Hosty-04/ChickenCoop/Flowcharts/door_flowchart_white.png

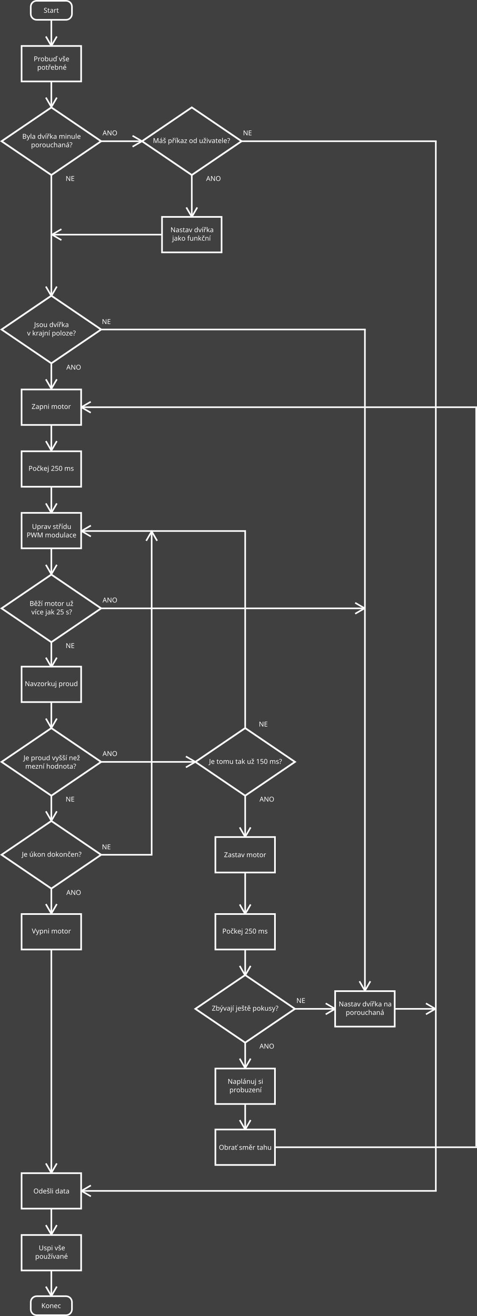
Flowcharts/door_flowchart_white.png
