Hosty-04/ChickenCoop/Flowcharts/egg_detection_flowchart_white.png

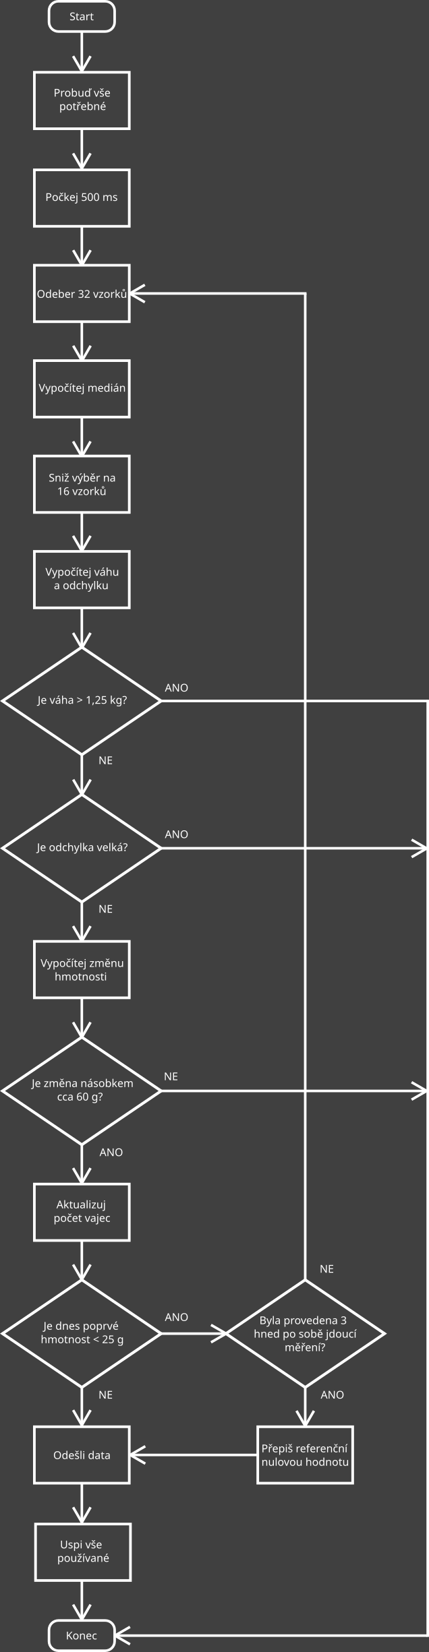
Flowcharts/egg_detection_flowchart_white.png
