Hosty-04/ChickenCoop/Flowcharts/separator_flowchart_white.png

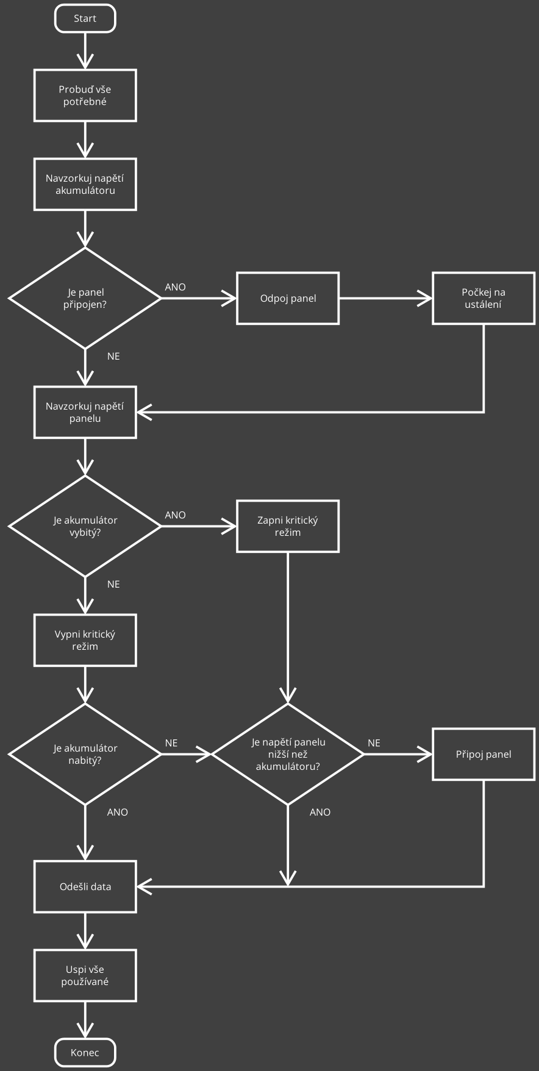
Flowcharts/separator_flowchart_white.png
