Hosty-04/ChickenCoop/Images/master_clock.png

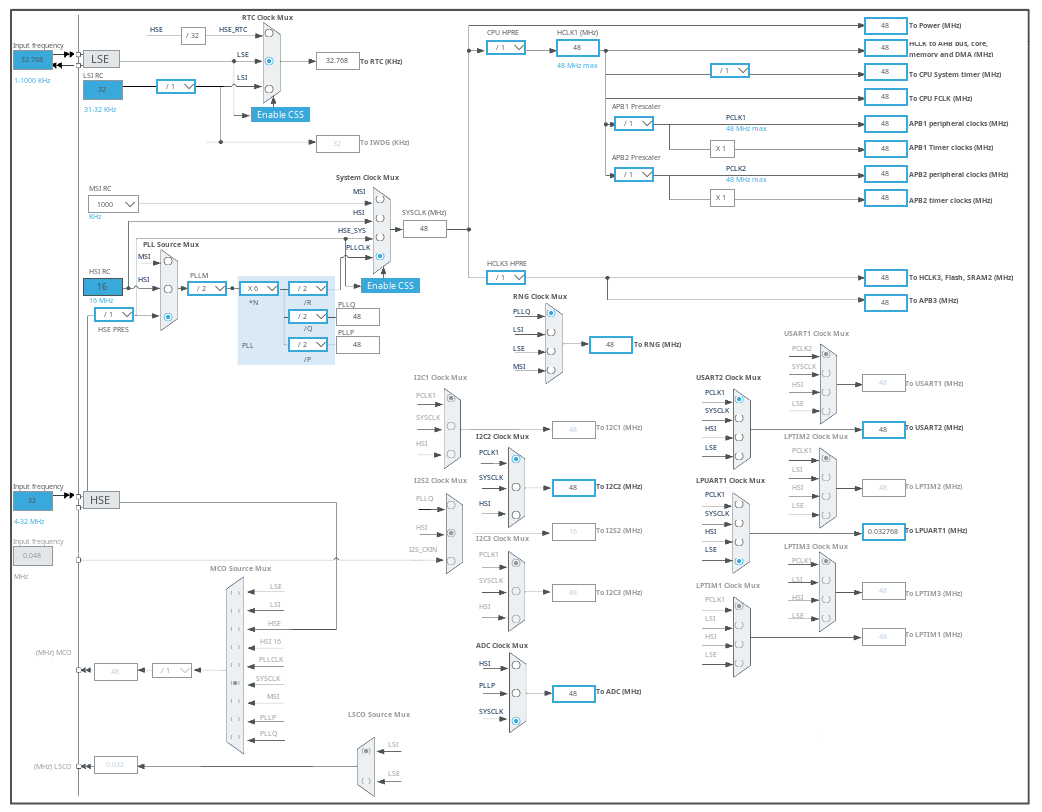
Images/master_clock.png
