Hosty-04/ChickenCoop/Images/master_gpio.png

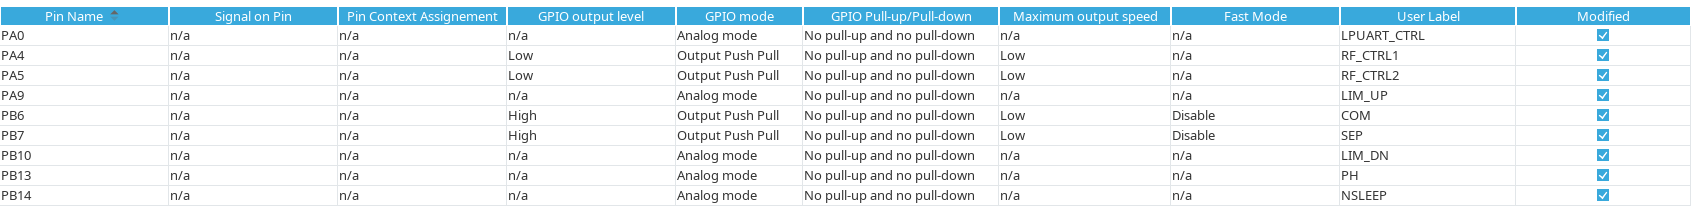
Images/master_gpio.png
