Hosty-04/ChickenCoop/Images/master_pinout.png

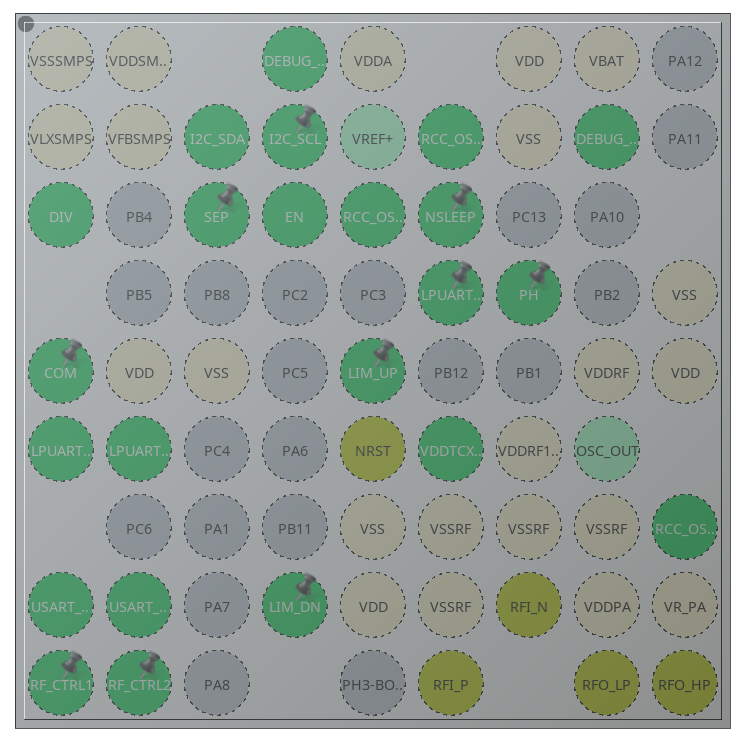
Images/master_pinout.png
