Hosty-04/ChickenCoop/Images/master_system.png

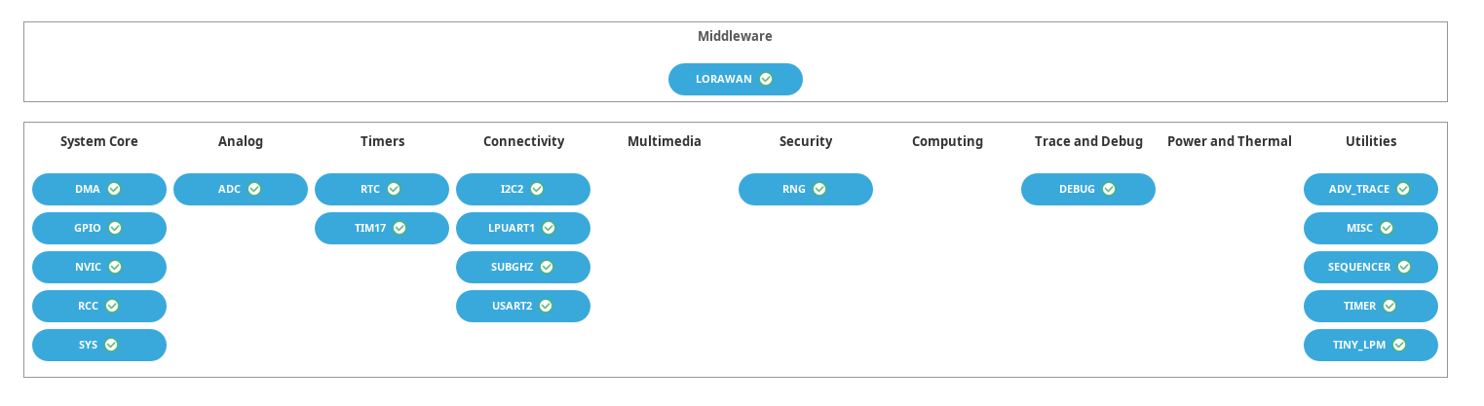
Images/master_system.png
