Hosty-04/ChickenCoop/Images/slave_clock.png

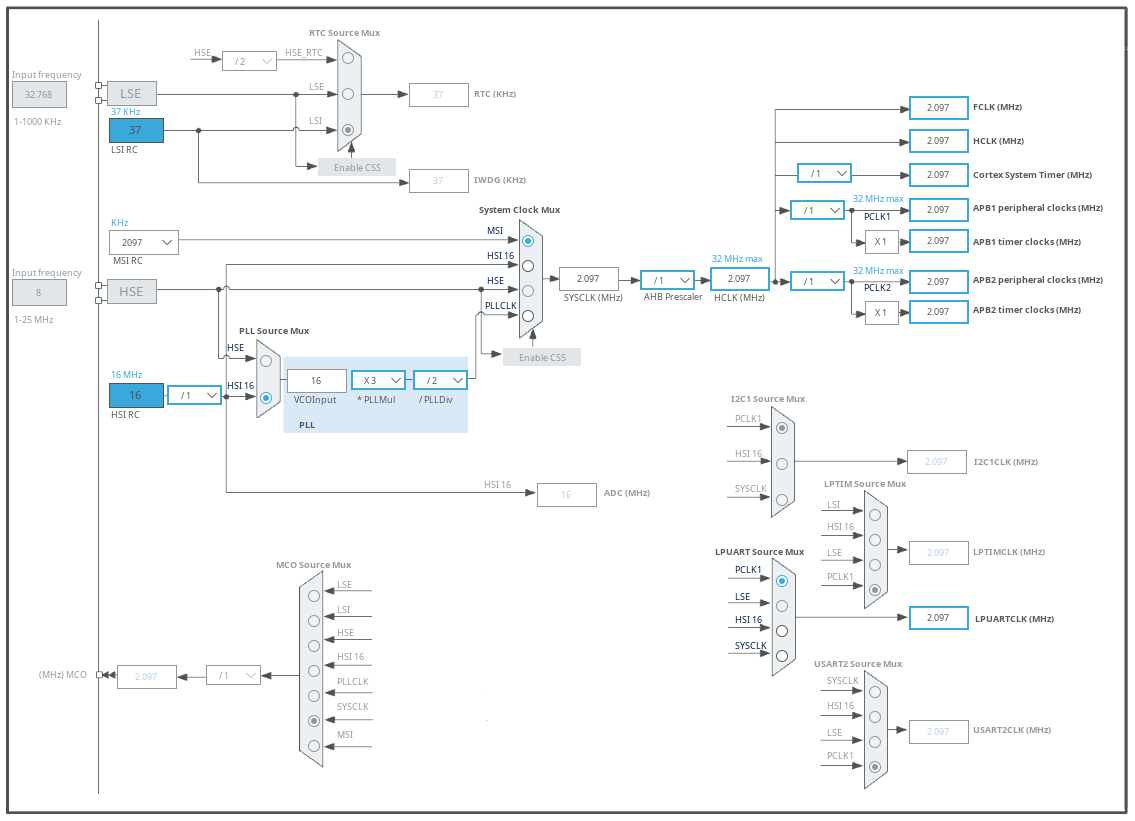
Images/slave_clock.png
