Hosty-04/ChickenCoop/Images/slave_pinout.png

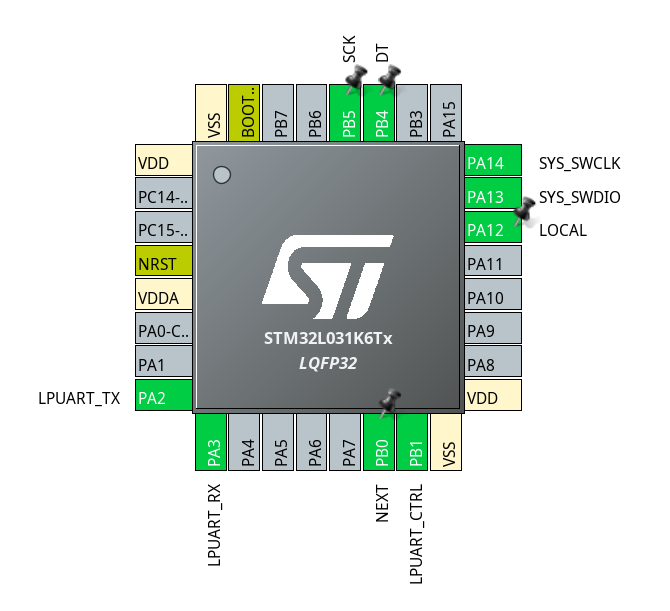
Images/slave_pinout.png
