Hosty-04/ChickenCoop/Schematics/block_schematic_comms_white.png

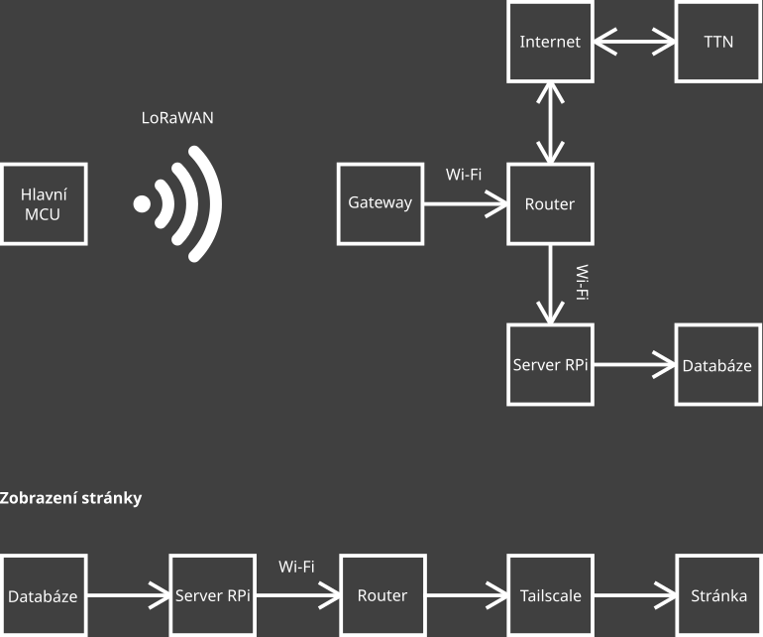
Schematics/block_schematic_comms_white.png
