Hosty-04/ChickenCoop/Schematics/block_schematic_electronics_white.png

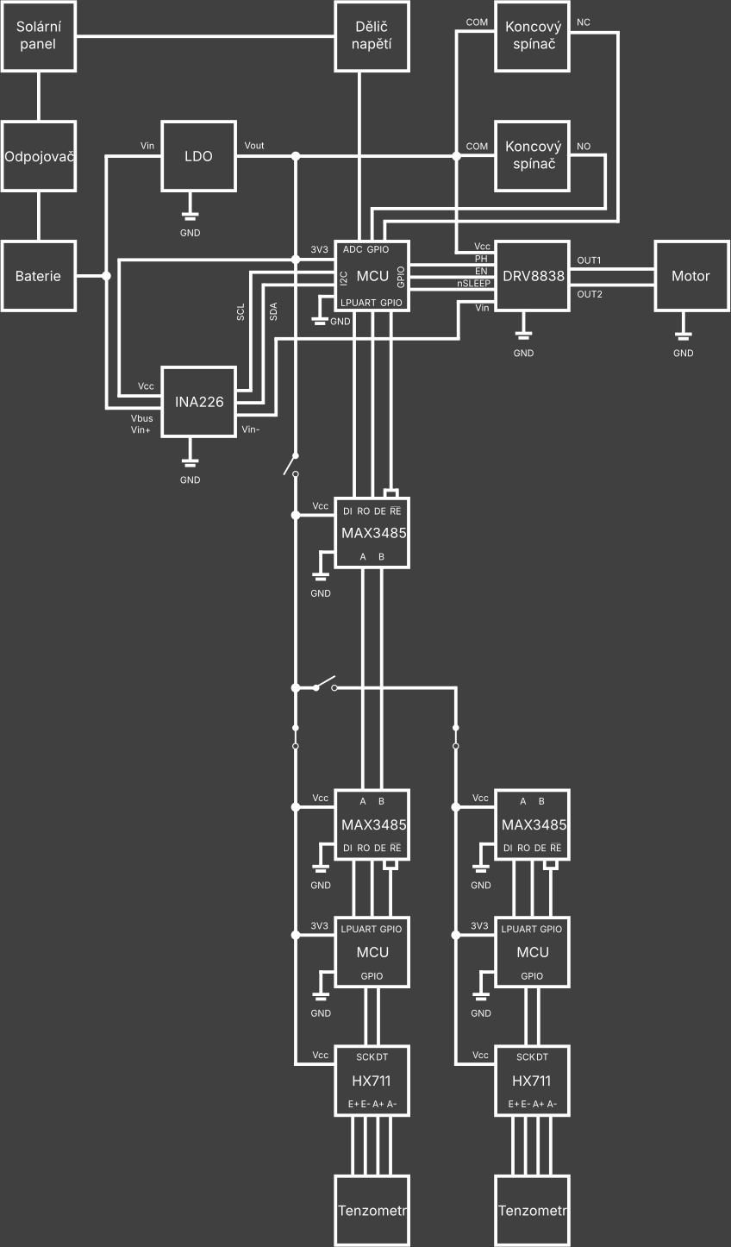
Schematics/block_schematic_electronics_white.png
