Hosty-04/ChickenCoop/Schematics/layout_black.png

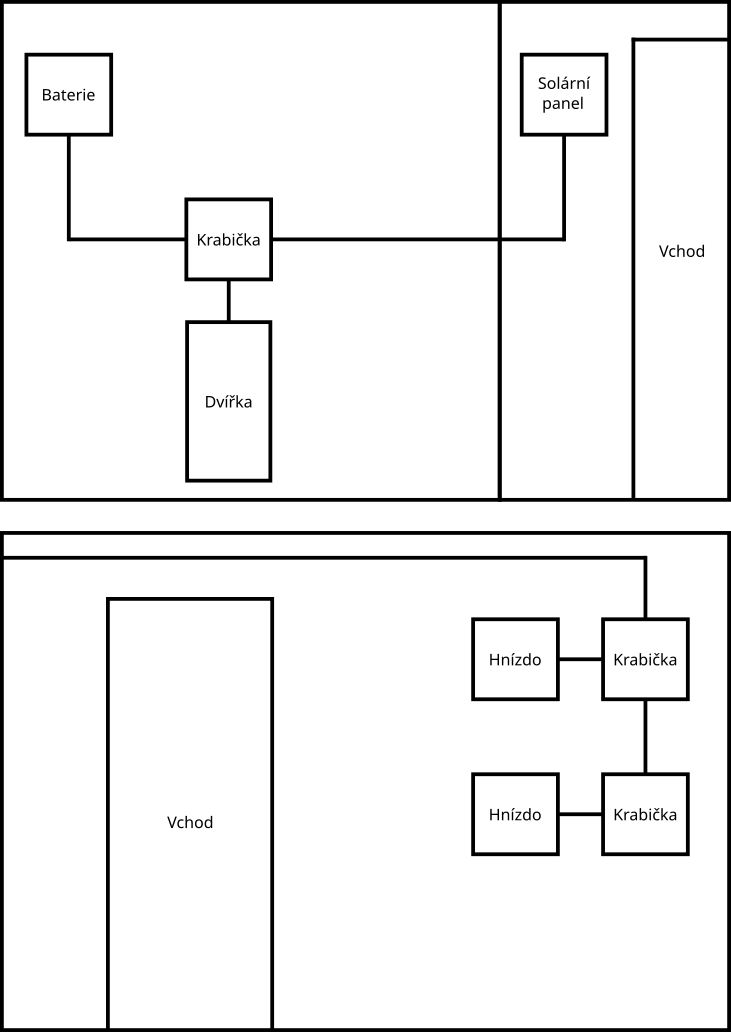
Schematics/layout_black.png
