Hosty-04/ChickenCoop/Schematics/layout_white.png

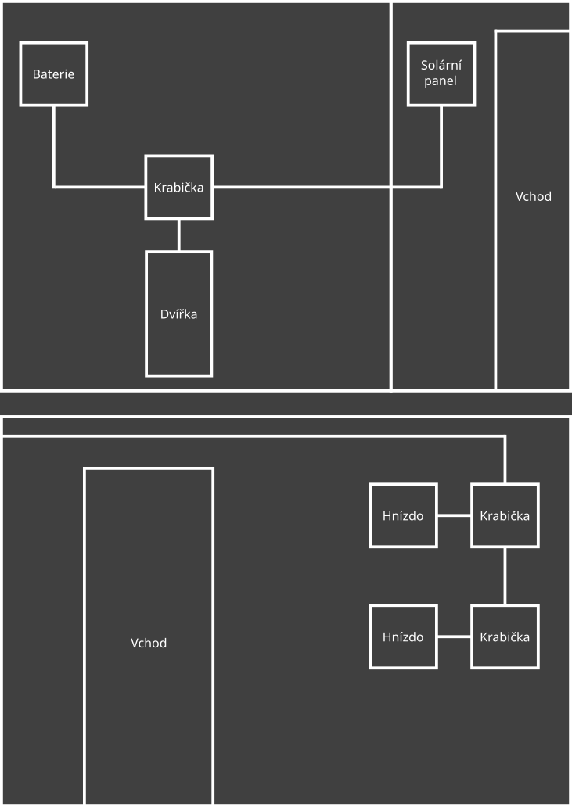
Schematics/layout_white.png
