Hosty-04/ChickenCoop/Schematics/peripheral_switches_schematic_white.png

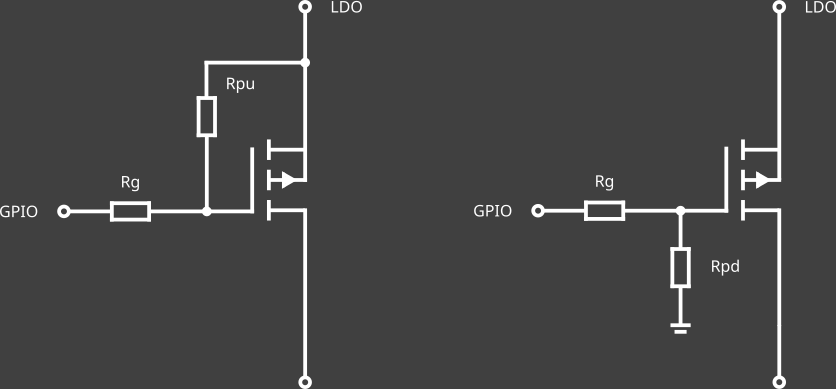
Schematics/peripheral_switches_schematic_white.png
