Hosty-04/ChickenCoop/Schematics/separator_schematic_white.png

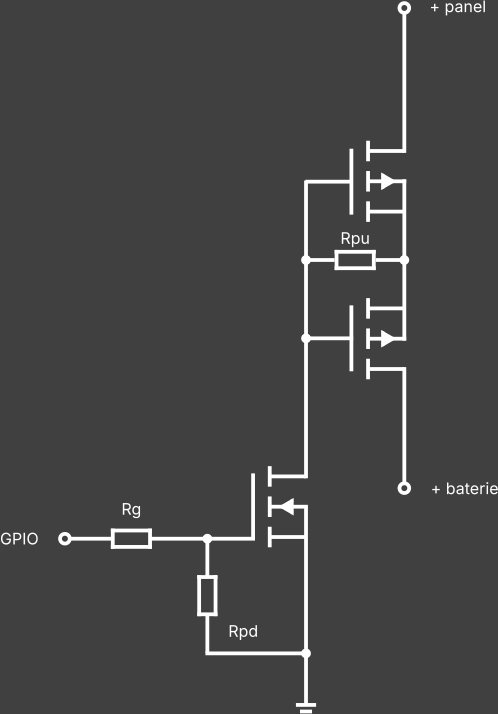
Schematics/separator_schematic_white.png
