Hosty-04/ChickenCoop/GUIDE.md

# Kurník

Automatická dvířka kurníku ovládaná přes internet. Kurník posílá každých 10 minut stav
baterie, solárního panelu a dvířek a každou hodinu počet vajec ve snáškových hnízdech;
z webové stránky lze dvířka kdykoli otevřít nebo zavřít.

```
kurník ──LoRa──> brána ──internet──> The Things Network ──> server na Pi ──> stránka
```

Příprava zabere asi hodinu. Kroky na sebe navazují, proto je vhodné dodržet jejich pořadí.

## Co je potřeba

- **Kurník** s namontovanou elektronikou
- **Brána** The Things Indoor Gateway a v domě Wi-Fi na 2,4 GHz
- **Raspberry Pi** a karta microSD — stačí i to nejmenší, podrobnosti níž
- **Tři údaje k zařízení**:

| Údaj | Vypadá jako | Odkud se bere |
|---|---|---|
| JoinEUI | `0101010101010101` | vždy tahle hodnota |
| DevEUI | `0080E115XXXXXXXX` | vyčte se z čipu, viz níž |
| AppKey | 32 znaků, například `2B7E1516…` | vygeneruje se, viz níž |

Bez nich se kurník k síti nepřipojí.

### DevEUI

Je to výrobní číslo čipu, nikde vytištěné není a musí se vyčíst přímo z něj. Potřeba je
programátor ST-LINK a nástroj STM32CubeProgrammer.

```bash
STM32_Programmer_CLI -c port=SWD -r32 0x1FFF7580 8
```

Výpis vypadá takto:

```
0x1FFF7580 : AABBCCDD 0080E115
```

DevEUI se složí tak, že **druhé číslo se dá před první**: `0080E115AABBCCDD`.
Druhé číslo musí být `0080E115` — podle toho se pozná, že jde o správné místo.

### AppKey

Tenhle klíč nikde vytištěný není a ani být nemůže: vymýšlí se a musí sedět na dvou místech
zároveň — v konzoli TTN a ve firmwaru kurníku. Když se liší, konzole hlásí `MIC mismatch`
a kurník se k síti nepřipojí.

Nejsnazší je nechat si ho vygenerovat. Při registraci zařízení (krok 4) je u pole **AppKey**
tlačítko **Generate**; objeví se 32 znaků, které si zkopírujte.

Do firmwaru patří do souboru `Master/LoRaWAN/App/se-identity.h`, po dvojicích oddělených
čárkami, a to do obou maker — mají stejnou hodnotu:

```c
#define LORAWAN_GEN_APP_KEY   2B,7E,15,16,28,AE,D2,A6,AB,F7,15,88,09,CF,4F,3C
#define LORAWAN_APP_KEY       2B,7E,15,16,28,AE,D2,A6,AB,F7,15,88,09,CF,4F,3C
```

Čárky doplní příkaz:

```bash
echo 2B7E151628AED2A6ABF7158809CF4F3C | sed 's/../&,/g; s/,$//'
```

Pak firmware přeložte, nahrajte do kurníku a kurník vypněte a zapněte.

> Klíč, který je ve zdrojovém kódu v tomhle repozitáři, si přečte kdokoliv. Pro ostré
> nasazení si vygenerujte vlastní a upravený soubor nezveřejňujte.

### Souřadnice kurníku

Dvířka se otevírají při východu slunce a zavírají hodinu po západu, aby slepice stihly
zajít dovnitř; kurník si oba časy počítá sám ze zeměpisné polohy. Ve firmwaru je přednastavené místo z vývoje; vlastní souřadnice patří do
souboru `Master/Core/Inc/main.h`:

```c
#define COOP_LATITUDE   49.5170f
#define COOP_LONGITUDE  17.6181f
```

Kladná čísla znamenají sever a východ, což platí pro celou Českou republiku. Polohu zjistíte
v mapách kliknutím pravým tlačítkem na dané místo. Stačí čtyři desetinná místa, to je zhruba
deset metrů; chyba jednoho stupně směrem na východ nebo západ posune oba časy o čtyři minuty.

Po úpravě firmware znovu přeložte a nahrajte do kurníku.

> Kurník počítá se středoevropským časem včetně přechodu na letní čas. Mimo tohle pásmo by
> se musel upravit i soubor `Master/Core/Src/timebase.c`.

### Počet hnízd

Firmware je nastavený na dvě snášková hnízda. Jiný počet (1 až 15) patří do souboru
`Master/Core/Inc/nests.h`:

```c
#define NESTS_COUNT          2U
```

Stejné číslo pak dostane i server, viz `NEST_COUNT` v kapitole 6. Hnízda se číslují od
krabičky nejblíž hlavní krabičce: první má adresu 1, druhá 2 a tak dál. Tu samou adresu
dostane řadič v dané krabičce v souboru `Slave/Core/Inc/nest.h`:

```c
#define NEST_ADDRESS  1U
```

Firmware hnízdového řadiče se proto pro každou krabičku přeloží a nahraje zvlášť, pokaždé
s její adresou.

## 1. Účet v The Things Network

Síť The Things Network je pro tohle využití zdarma.

1. Registrace na <https://www.thethingsnetwork.org/>
2. Přihlášení do konzole na <https://eu1.cloud.thethings.network/console/>

Je potřeba použít evropskou konzoli (`eu1`) — brána i kurník s ní počítají.

## 2. Brána

Na spodní straně brány je štítek se dvěma údaji: **Gateway EUI** a **WiFi PW**. Potřeba jsou oba.

### Wi-Fi

1. Zapojte bránu do zásuvky
2. Podržte tlačítko **SETUP** asi 5 vteřin, dokud kontrolka nezačne rychle blikat
3. Brána si vytvoří vlastní Wi-Fi síť **MINIHUB-xxxxxx**; připojte se k ní z mobilu, heslo je **WiFi PW** ze štítku
4. V prohlížeči otevřete **192.168.4.1**
5. U domácí sítě klikněte na **+** a zadejte k ní heslo
6. Klikněte na **Save and Reboot**

Kontrolka chvíli bliká zeleně, pak střídavě zeleně a červeně. To je v pořádku: brána už je
na Wi-Fi, ale ještě nemá, kam se přihlásit — účet jí dá až registrace v dalším kroku.

> **Brána umí jen 2,4 GHz.** Síť, která vysílá pouze na 5 GHz, se v seznamu vůbec neobjeví.
> Nefungují ani sítě s přihlašovací stránkou v prohlížeči a firemní sítě typu eduroam.

### Registrace v konzoli

V konzoli otevřete **Gateways** a zvolte **Claim gateway** — *ne* Register gateway. Claim bránu zaregistruje sám a pošle jí přihlašovací údaje; bez něj se k síti nepřipojí.

| Pole | Hodnota |
|---|---|
| Gateway EUI | ze štítku |
| Claim authentication code | **WiFi PW** ze štítku |
| Frequency plan | Europe 863-870 MHz (SF9 for RX2) |

Do minuty má brána nahoře svítit **Connected**.

## 3. Aplikace

V konzoli **Applications → Add application**. Vyplňte jen ID, například `kurnik`. Ostatní pole nechte být.

## 4. Zařízení

V aplikaci **End devices → Register end device** a zvolte **Enter end device specifics manually**.

| Pole | Hodnota |
|---|---|
| Frequency plan | Europe 863-870 MHz (SF9 for RX2) |
| LoRaWAN version | LoRaWAN Specification 1.0.4 |
| Regional Parameters version | RP002 Regional Parameters 1.0.4 |
| Activation mode | Over the air activation (OTAA) |
| Additional LoRaWAN class capabilities | None (class A only) |
| JoinEUI, DevEUI | dva údaje z úvodu |
| AppKey | tlačítkem **Generate**, pak ho zapište do firmwaru |

Zapněte kurník. Během pár minut se na kartě **Live data** (v konzoli u zařízení) objeví
`Accept join-request` a pak první zpráva.

## 5. Dekódování dat

Bez tohoto kroku jsou místo napětí vidět jen čísla v hexadecimální soustavě.

V aplikaci **Payload formatters → Uplink** zvolte **Custom Javascript formatter** a vložte:

```js
function decodeUplink(input) {
  var b = input.bytes;
  if (input.fPort !== 2 || b.length < 2) {
    return { data: {}, errors: ["neocekavany port nebo delka"] };
  }
  var panel = b[0] >> 1;
  var batt = b[1] >> 2;
  var data = {
    panel_mv: panel === 127 ? null : panel * 100,
    battery_mv: batt === 63 ? null : 5000 + batt * 50,
    battery_critical: (b[0] & 1) === 1,
    door: ["zavreno", "otevreno", "porucha", "neznamy"][b[1] & 3]
  };
  if (b.length > 2) {
    data.nests = [];
    for (var i = 2; i < b.length; i++) {
      data.nests.push(nest(b[i] >> 4), nest(b[i] & 15));
    }
  }
  return { data: data, warnings: [], errors: [] };
}

function nest(code) {
  if (code <= 10) return code;
  return { 11: "kvocna", 12: "nekalibrovano", 13: "nevynulovano", 14: "porucha" }[code] || null;
}
```

Uložte a počkejte na další zprávu — kurník se ozývá po deseti minutách. Pak už jsou
v **Live data** místo šestnáctkových čísel vidět napětí a stav dvířek. Jednou za hodinu
přibude seznam `nests` s počtem vajec v každém hnízdě; `null` znamená hnízdo, které se
neozvalo. Při lichém počtu hnízd je `null` vždycky i na konci seznamu — to jen dorovnává
poslední bajt zprávy.

## 6. Server

Server přebírá zprávy z The Things Network, ukládá je a zobrazuje na stránce.
Musí běžet nepřetržitě — co zmešká, to je pryč.

### Jaké Pi

**Stačí i to nejlevnější.** Server si bere kolem 100–150 MB paměti a data ukládá do jediného
souboru, takže se vejde na **Raspberry Pi Zero 2 W** s 512 MB. Spotřebuje kolem 1 W,
tedy asi 50 Kč elektřiny za rok. Silnější Pi 4 nebo 5 poslouží také, jen stojí víc
a mají vyšší spotřebu; u Zero 2 W je naopak potřeba počítat s tím, že první sestavení serveru
potrvá i deset minut.

Systém může být 32bitový i 64bitový, na tom nezáleží. Kromě Pi stačí karta microSD,
8 GB bohatě vystačí — měření za celý rok zabere asi 4 MB.

### Příprava karty

V **Raspberry Pi Imageru** zvolte **Raspberry Pi OS Lite**. Pod ozubeným
kolečkem nastavte:

- hostname `kurnik`
- zapnuté SSH
- uživatelské jméno a heslo
- síť Wi-Fi

Díky tomu není potřeba monitor ani klávesnice.

### Docker

Přihlaste se a nainstalujte:

```bash
ssh uzivatel@kurnik.local
sudo apt update && sudo apt full-upgrade -y
sudo apt install -y git
curl -fsSL https://get.docker.com | sh
sudo usermod -aG docker $USER
```

Místo `uzivatel` patří jméno zadané v Imageru.

**Pak se odhlaste a přihlaste znovu**, jinak bude Docker hlásit chybu oprávnění.

### Klíč pro přístup k síti

V konzoli TTN v aplikaci **API keys → Add API key**. Klíč pojmenujte, zvolte **Grant
individual rights** a zaškrtněte:

- Read application traffic (uplink and downlink)
- Write downlink application traffic

Po uložení se klíč začínající `NNSXS.` **zobrazí jen jednou** — zkopírujte si ho hned.

### Nastavení

```bash
git clone https://github.com/Hosty-04/ChickenCoop.git
cd ChickenCoop/Server
cp .env.example .env
nano .env
```

Doplňte čtyři hodnoty:

| Proměnná | Co tam patří |
|---|---|
| `AUTH_PASSWORD` | heslo pro přihlášení ke stránce |
| `TTN_APP_ID` | ID aplikace z kroku 3 |
| `TTN_DEVICE_ID` | ID zařízení z kroku 4 |
| `TTN_API_KEY` | klíč vytvořený v předchozím kroku |

Heslo si zvolte sami; dlouhé a náhodné vygeneruje příkaz `openssl rand -base64 18`.

Kurník s jiným počtem hnízd než dvěma potřebuje ještě řádek `NEST_COUNT` se stejným číslem,
jaké je ve firmwaru (kapitola **Počet hnízd** v úvodu). Server podle něj ví, kolik hnízd
na stránce ukázat a jak rozložit čísla ve zprávě.

Řádek `TZ=Europe/Prague` nechte být, pokud kurník nestojí v jiném časovém pásmu. Podle něj
server dělí měření na dny, takže v grafu začíná den o půlnoci u vás, ne v Londýně. Ve stejném
pásmu ukazuje stránka i všechny časy, takže na cestách v cizině vidíte čas kurníku, ne čas
telefonu.

> **Heslo ke stránce nepoužívejte nikde jinde.** Je v souboru `.env` v čitelné podobě,
> stejně jako klíč k TTN. Kdo se dostane k tomu souboru, má stejně tak celý systém.

### Spuštění

```bash
docker compose up -d
```

**Poprvé to chvíli trvá** — server se musí sestavit, na Zero 2 W klidně deset minut.
Že se rozběhl, ukáže výpis:

```bash
docker compose logs -f app
```

Mají se objevit řádky `dashboard on http://localhost:3000` a `TTN connected`. Sledování
ukončíte klávesami Ctrl+C, server běží dál.

Databáze se založí při prvním spuštění. Po restartu Pi se všechno spustí samo.

### Kde jsou data

Naměřené hodnoty neleží uvnitř kontejneru, ale v odděleném úložišti `server_coop-data`
na kartě Pi. Proto přežijí:

- restart serveru i celého Pi, včetně výpadku proudu
- `docker compose down` a nové spuštění
- aktualizaci a nové sestavení serveru
- smazání obrazu, třeba příkazem `docker image prune`

Přijít se o ně dá jen dvěma způsoby: příkazem `docker compose down -v` (to `-v` smaže
i úložiště) nebo `docker volume rm server_coop-data`. Oboje je nevratné, takže se hodí
mít zálohu.

> Při náhlém výpadku proudu může chybět poslední měření nebo dvě, která ještě nebyla
> zapsaná na kartu. Databáze jako taková zůstane v pořádku.

### Běžný provoz

Všechny příkazy se spouštějí ze složky `ChickenCoop/Server`.

| Co | Příkaz |
|---|---|
| Zjistit, jestli server běží | `docker compose ps` |
| Sledovat výpis | `docker compose logs -f app` |
| Zastavit | `docker compose down` |
| Spustit | `docker compose up -d` |
| Změnit heslo nebo klíče | upravit `.env`, pak `docker compose up -d` |

> Po úpravě `.env` nestačí `docker compose restart` — ten kontejner jen restartuje
> s původním nastavením. Nové hodnoty načte až `docker compose up -d`.

### Aktualizace

```bash
cd ~/ChickenCoop
git pull
cd Server
docker compose up -d --build
```

**Bez `--build`** by Docker spustil dřív sestavenou verzi a změny by se neprojevily.
Naměřená data zůstanou, ta jsou mimo kontejner.

### Záloha

Celá historie měření je jeden soubor. Server je při kopírování potřeba zastavit, jinak
může část posledních měření zůstat v pomocném souboru a do zálohy se nedostane:

```bash
docker compose stop
docker compose cp app:/data/kurnik.db ~/kurnik-zaloha.db
docker compose start
```

Obnova je totéž obráceně:

```bash
docker compose stop
docker compose cp ~/kurnik-zaloha.db app:/data/kurnik.db
docker compose start
```

Kopíruje se vždy celý soubor a uloží se pod jménem z cílové cesty: ze `kurnik-zaloha.db` se
uvnitř stane `kurnik.db` a původní databázi přepíše.

Zastavení trvá pár vteřin. Kdyby kurník zrovna v tu chvíli poslal zprávu, přijde se o ni —
další dorazí za deset minut.

### Obnova po výpadku proudu

Server si za běhu vedle `kurnik.db` drží ještě `kurnik.db-wal` a `kurnik.db-shm`. Při čistém
zastavení se jejich obsah zapíše do `kurnik.db` a samy zmizí, ale po výpadku proudu nebo po
vypnutí Pi natvrdo tam zůstanou. Kdyby je potom našla vedle sebe nově nakopírovaná databáze,
SQLite je na ni přehraje a poškodí ji. **Proto se v takovém případě před obnovou podívejte,
co v úložišti leží.**

Se zastaveným serverem vypište jeho obsah:

```bash
docker run --rm -v server_coop-data:/data alpine ls -l /data
```

Je tam jen `kurnik.db`? Kopírujte zálohu podle postupu výše. Je tam i `-wal` nebo `-shm`?
Nejdřív je smažte:

```bash
docker run --rm -v server_coop-data:/data alpine rm -f /data/kurnik.db-wal /data/kurnik.db-shm
```

Po běžném zastavení příkazem `docker compose stop` tam nic takového nebude a obnova se dá
spustit rovnou.

## 7. Přístup ke stránce

Stránka je dostupná z čehokoliv v domácí síti — z počítače i z telefonu. Nejdřív je
potřeba znát adresu Pi, zbytek se pak liší jen drobnostmi podle zařízení.

> **Kdo si nastaví Tailscale, vystačí si s ním i doma** a zbytek téhle kapitoly může
> přeskočit. Jeho adresa odpovídá na domácí Wi-Fi stejně jako z mobilních dat, takže stačí
> jediná a nemusí se nic přepínat. Domácí adresa má proti tomu tu výhodu, že nevyžaduje
> žádný účet ani aplikaci.

### Adresa Pi

Stránka běží na Pi, takže se na ni chodí přes jeho adresu. Napsat jde dvěma způsoby.

**Jméno `kurnik.local`** je pohodlnější, protože si není co pamatovat. Funguje na Windows,
macOS, běžných linuxových distribucích i na iPhonu; na Linuxu k tomu může chybět služba,
kterou doinstaluje `sudo apt install avahi-daemon`. Na Androidu je to nejisté — novější
verze systému jméno přeloží, starší ne.

**IP adresa** funguje všude. Vypíše ji na Pi příkaz `hostname -I`, vyjde například
`192.168.1.42`; druhá možnost je najít `kurnik` v seznamu připojených zařízení v routeru.
Po výpadku proudu se ale může změnit, a tím přestane fungovat i uložená ikona. Proto ji
zafixujte. Postup je u všech routerů stejný, liší se jen pojmenování:

1. Otevřete nastavení routeru. Jeho adresu vypíše na Pi příkaz `ip route | grep default`,
   bývá to `192.168.1.1` nebo `192.168.0.1`. Přihlašovací údaje jsou obvykle na štítku
   routeru.
2. Najděte oddíl **LAN** nebo **DHCP**. Hledaná položka se jmenuje **DHCP reservation**,
   **Address reservation**, **Static lease** nebo česky **rezervace adres**.
3. Ze seznamu připojených zařízení vyberte `kurnik`. Když seznam není, zadejte MAC adresu
   ručně — vypíše ji `ip link show` na Pi, řádek `link/ether` u `wlan0` pro Wi-Fi nebo
   u `eth0` pro kabel.
4. Uložte a Pi restartujte. Že se adresa opravdu ujala, ověří `hostname -I`.

**Když se do routeru nedostanete** — u krabic od poskytovatele bývá správcovský účet
zamčený — dá se adresa zafixovat přímo na Pi. Nejdřív si na něm zjistěte tři údaje:

```bash
hostname -I               # současná adresa Pi, třeba 192.168.1.42
ip route | grep default   # adresa routeru, je za slovem via
nmcli con show            # název připojení, na Raspberry Pi OS bývá preconfigured
```

Ty tři hodnoty se dosadí do následujícího příkazu. `preconfigured` je název připojení,
`192.168.1.42` adresa, kterou má Pi napevno dostat, a `192.168.1.1` router — ten slouží
zároveň jako DNS:

```bash
sudo nmcli con mod preconfigured ipv4.method manual \
  ipv4.addresses 192.168.1.42/24 \
  ipv4.gateway 192.168.1.1 \
  ipv4.dns 192.168.1.1
sudo reboot
```

`/24` na konci adresy říká, že první tři čísla jsou společná pro celou domácí síť. U sítí
začínajících `192.168.` to platí prakticky vždy.

> **Vybraná adresa musí být volná a volná i zůstat.** Router rozdává adresy z nějakého
> rozsahu, obvykle od `.100` do `.200`; kdyby ta vaše byla uvnitř, mohl by ji časem přidělit
> i jinému zařízení a obě by se o ni praly. Bezpečné je proto nízké číslo, třeba `.42`.
> Že je volné, ověříte z jiného počítače v síti — Pi zatím vypněte a zkuste
> `ping 192.168.1.42`. Nesmí odpovídat nikdo.

Některé routery umí k IP adrese přiřadit i vlastní jméno; bývá to hned vedle rezervace adres,
případně v oddílu **DNS**. Když se tam `kurnik` přiřadí k adrese Pi, funguje pak na všech
zařízeních v domácí síti adresa `http://kurnik:3000` a IP adresu si nikdo pamatovat nemusí.
Umí to ale jen některé routery; u většiny běžných tahle volba chybí.

### Doma z počítače

Otevřete **`http://kurnik.local:3000`**, nebo s IP adresou `http://192.168.1.42:3000`.
Pro rychlé spuštění si udělejte záložku nebo zástupce na ploše.

### Doma z iPhonu

Stejně jako na počítači: **`http://kurnik.local:3000`**, jméno si telefon přeloží sám.
Po přihlášení zvolte **Sdílet → Přidat na plochu** a vznikne ikona, ze které se stránka
otevře bez adresního řádku jako aplikace.

### Doma z Androidu

Protože jméno `kurnik.local` tu nemusí fungovat, počítejte s IP adresou:

1. **Zadejte celou adresu včetně `http://`**, tedy `http://192.168.1.42:3000`. Bez toho ji
   prohlížeč pošle do vyhledávače.
2. **Kdyby prohlížeč přepnul na `https://`** a stránka nenaběhla, vypněte vynucování:
   v Chrome **⋮ → Nastavení → Soukromí a zabezpečení → Vždy používat zabezpečená připojení**,
   ve Firefoxu **⋮ → Nastavení → Soukromí a zabezpečení → Režim pouze HTTPS**.
3. Přihlaste se jménem `kurnik` a heslem z `.env`, pak v nabídce zvolte **Přidat na plochu**.
   Tuhle volbu má Chrome i Firefox, jen ji každý řadí jinam. Vznikne ikona, která stránku
   otevře na jedno klepnutí.

> Ikona na Androidu otevře stránku v prohlížeči i s adresním řádkem. Aby se otevírala
> samostatně jako aplikace, musela by stránka běžet přes HTTPS — po domácím HTTP to žádný
> prohlížeč nenabídne. Na funkci to nemá vliv.

> **Dotaz na přístup k místní síti povolte.** Ptá se Chrome i Firefox, na Androidu 16
> a novějším i samotný systém. Je to ochrana proti stránkám z internetu, které by jinak
> mohly prohledávat domácí síť; tahle stránka běží přímo na Pi a nic dalšího nehledá.

### Mimo domov

> **Nikdy neotevírejte port 3000 do internetu.** I když je stránka chráněná heslem,
> vystavovat ji veřejně je zbytečné riziko — kdo se dostane dovnitř, otevře dvířka.
> Heslo navíc po holém HTTP cestuje nešifrovaně.

Řešením je **Tailscale**. Vytvoří privátní síť jen z vlastních zařízení: každé dostane
adresu `100.x.y.z`, kterou nikdo jiný nevidí, a provoz mezi nimi je šifrovaný. Do internetu
se nic neotevírá a není potřeba veřejná IP adresa, takže to funguje i na připojeních, kde
přesměrování portů vůbec nejde. Pro osobní použití je zdarma.

#### Na Raspberry Pi

```bash
curl -fsSL https://tailscale.com/install.sh | sh
sudo tailscale up
```

Druhý příkaz vypíše odkaz. Otevřete ho v prohlížeči a přihlaste se — účtem Google, GitHub,
Microsoft nebo e-mailem. Adresu, kterou Pi v téhle síti dostalo, pak vypíše:

```bash
tailscale ip -4
```

> **Vypněte vypršení klíče.** Tailscale po 180 dnech vyžaduje nové přihlášení a server by
> ze sítě tiše vypadl. Na <https://login.tailscale.com> u zařízení `kurnik` zvolte
> **Disable key expiry**. U serveru, který má běžet pořád, je to důležité.

#### Na ostatních zařízeních

Do telefonu nainstalujte aplikaci **Tailscale** z Obchodu Play nebo App Store, do počítače
program ze stránek <https://tailscale.com/download> (Windows, macOS i Linux). Všude se
přihlaste **stejným účtem** a zapněte připojení. V seznamu zařízení se objeví `kurnik`
i se svou adresou.

Stránku pak otevřete na `http://100.x.y.z:3000`. Když v konzoli Tailscale zapnete
**MagicDNS**, stačí kratší `http://kurnik:3000`.

**Ikonu si udělejte právě z téhle adresy.** Funguje doma i z mobilních dat
a z cizí sítě, takže stačí jediná — na rozdíl od domácí adresy, která mimo domov neodpoví.

Aplikace drží připojení zapnuté; vypnout jde přepínačem, ale pak stránka mimo domov
nenaběhne. Tunelem prochází jen provoz na vlastní zařízení, běžné prohlížení internetu jde
mimo něj.

## Ověření

| Kde | Co má být vidět |
|---|---|
| Konzole, Gateways | brána **Connected** |
| Konzole, zařízení | zpráva každých 10 minut |
| Pi, `docker compose logs app` | `TTN connected` a každých 10 minut řádek `uplink`, jednou za hodinu s `nests=` |
| Stránka | po přihlášení naměřená napětí, stav dvířek a vejce v hnízdech |

## Co je na stránce

Stránka má odshora záhlaví, volbu rozsahu, pět dlaždic s aktuálním stavem, karty **Hnízda**,
**Snáška**, **Napájení** a **Ovládání** a nakonec kartu **Data** s počtem uložených záznamů,
ze kterých se skládají Napájení a Snáška, a tlačítkem pro smazání historie. Nové hodnoty se
doplňují samy, stránku není potřeba načítat znovu.

Otevřených oken může být víc — třeba telefon a počítač zároveň. Co uděláte v jednom, se
hned ukáže i v ostatních: zařazený příkaz, zrušená fronta, nově naměřené hodnoty i smazání
historie. Volba rozsahu, výběr hnízd a přepnutí grafu na tabulku platí jen v okně, kde je
zvolíte.

### Záhlaví stránky

Vpravo nahoře svítí indikátor spojení serveru s The Things Network. Vedle něj je na počítači
a pod ním na telefonu přepínač světlého a tmavého motivu a odhlášení.

| Indikátor | Co znamená |
|---|---|
| **TTN připojeno** | server je spojený se sítí; jestli se ozývá i kurník, ukazuje dlaždice **Poslední zpráva** |
| **TTN odpojeno** | server ztratil spojení se sítí; stránka ukazuje poslední známé hodnoty a příkaz nejde zařadit ani frontu zrušit |
| **připojuji…**, po pěti sekundách **Server nedostupný** | stránka ztratila spojení se serverem; jakmile zase odpoví, připojí se sama |

Když databáze nemůže ukládat, objeví se mezi indikátorem a tlačítky červené **Plná databáze**,
u jiné chyby **Chyba databáze**. Kliknutím se stránka posune ke kartě **Data** s celou hláškou.
Varování zmizí samo, jakmile se zase uloží další zpráva; co s ním dělat, je v kapitole
**Když to nejede**. Na stejném místě se objeví červené **Odhlášení selhalo**, když se odhlášení
nepovede, protože server neodpovídá; zmizí při dalším pokusu.

### Dlaždice

| Dlaždice | Co ukazuje | Poznámka pod hodnotou |
|---|---|---|
| **Baterie** | napětí z poslední zprávy | **⚠ kriticky vybitá**, **⚠ čidlo neodpovídá** nebo **na horní mezi rozsahu** |
| **Panel** | napětí solárního panelu z poslední zprávy | **⚠ čidlo neodpovídá** nebo **na horní mezi rozsahu** |
| **Dvířka** | **Otevřeno**, **Zavřeno**, **Porucha** nebo **Neznámý** | u poruchy **⚠ čeká na odblokování**, u neznámé polohy **⚠ koncový spínač nehlásí polohu** |
| **Poslední zpráva** | čas poslední zprávy, z jiného dne i s datem | jak je to dávno a síla signálu, třeba **před 5 min (-97 dBm)** |
| **Automatika** | **Zapnutá**, **Vypnutá** nebo **–** | u vypnuté **⚠ od** a čas vypnutí, u pomlčky **⚠ stav se neuložil** |

Dokud nepřišla žádná zpráva, ukazují první čtyři dlaždice pomlčku. Poznámky **⚠ čidlo
neodpovídá** a **na horní mezi rozsahu** vysvětluje část **Když data chybí**.

Podle slunce se dvířka otevírají a zavírají, jen když kurník zná napětí baterie a ta není
kriticky vybitá. Při **⚠ kriticky vybité** baterii kurník šetří: dvířka zůstanou, kde jsou,
a nekontrolují se ani hnízda. Při **⚠ čidlo neodpovídá** u baterie se dvířka zastaví také,
hnízda se kontrolují dál. Zprávy chodí v obou případech a ručně dvířka otevřít nebo zavřít
jde i tak. Jakmile je baterie zase v pořádku, dvířka hned dojedou tam, kde mají podle slunce
být.

**Porucha** u dvířek znamená, že stojí a nepohnou se, dokud nepřijde **Odblokovat**. Buď jim
něco překáželo nebo nedojela do koncové polohy (viz **Když to nejede**), nebo dostala příkaz
**Zablokovat**.

Automatiku stránka zná z posledního příkazu **Zapnout** nebo **Vypnout**, jehož příjem kurník
potvrdil; dokud žádný takový nebyl, ukazuje výchozí **Zapnutá**. Když se potvrzený stav
nepodaří uložit, ukáže dlaždice pomlčku, protože po restartu serveru by jinak ukazovala starý
stav.

### Hnízda

Každé hnízdo má svůj zásobník s deseti místy, která se plní tak, jak přibývají vejce. Nad ním
je jejich počet, pod ním, kolik jich v hnízdě dnes přibylo. Kurník hnízda kontroluje každou
celou hodinu a hned po nich změří baterii a panel, takže obojí dorazí v jedné zprávě. Čas
poslední kontroly je v záhlaví karty i se součtem za celý den. Po vynulování nebo kalibraci
váhy přijde zpráva o hnízdech i mimo celou hodinu; hnízda, kterých se příkaz netýkal, kurník
při té příležitosti změří stejně jako při hodinové kontrole, takže zpráva nese aktuální stav
všech hnízd.

Na telefonu je každé hnízdo jeden řádek: vlevo název a počet, vpravo zásobník a pod ním
poznámka. I patnáct hnízd se tak vejde zhruba na jednu obrazovku.

| Poznámka | Co znamená |
|---|---|
| **⚠ košík je plný** | v hnízdě je deset vajec, víc se jich do zprávy nevejde — je čas je vybrat |
| **⚠ sedí kvočna** | váha tři kontroly po sobě ukázala slepici; počet je z doby, kdy hnízdo bylo volné |
| **⚠ váha není zkalibrovaná, nejdřív ji vynulujte** | hnízdo ještě nikdy nebylo vynulované; bez toho se kalibrace neprovede, viz **Kalibrace váhy** |
| **⚠ váha není zkalibrovaná** | váha je vynulovaná, zbývá ji zkalibrovat se závažím, viz **Kalibrace váhy** |
| **⚠ porucha váhy** | převodník u tenzometru neodpovídá nebo měří nesmysly, nebo se nepovedlo vynulování či kalibrace |
| **⚠ hnízdo neodpovídá** | řadič v krabičce hnízda se neozval; počet je z poslední úspěšné kontroly |

Hnízda jsou napájená jedno od druhého, takže když se neozve první, neozvou se ani ta za ním.

Při kriticky vybité baterii a při vypnuté automatice kurník hnízda každou hodinu
nekontroluje. Karta pak ukazuje poslední kontrolu i s jejím datem; při vypnuté automatice
ji obnoví jen vynulování nebo kalibrace.

### Snáška a Napájení

Histogram **Snáška** ukazuje, kolik vajec ve všech hnízdech přibylo, graf **Napájení** napětí
baterie a panelu. Oba se řídí volbou rozsahu nahoře — 6 hodin, 24 hodin, 7 dní, 30 dní, rok,
nebo **Vše** od prvního měření. Tlačítkem **Tabulka** se každý z nich přepne na stejná data
v číslech. Popisek bodu nebo sloupce se na počítači ukáže po najetí myší, na telefonu po
klepnutí.

Čím delší rozsah, tím delší okno, za které se měření průměrují a vejce sčítají. Každý pohled
tak má nanejvýš pár stovek bodů, ať pokrývá den nebo pět let.

| Rozsah | Napájení, průměr za | Snáška, sloupec za | Výpadek je v Napájení vidět od |
|---|---|---|---|
| 6 h a 24 h | 10 minut — každý bod je jedno měření | hodinu | 20 minut |
| 7 dní | hodinu | den | 2 hodin |
| 30 dní | 6 hodin | den | 12 hodin |
| 1 rok | den | týden | 2 dnů |
| Vše | podle délky historie | podle délky historie | podle okna |

Ve **Vše** se okno řídí tím, jak dlouhá je historie: Napájení se průměruje do dne po
10 minutách, do týdne po hodině, do měsíce po 6 hodinách, do roku po dnech, do dvou let
po týdnech a dál po měsících; Snáška má sloupce do dne po hodinách, do měsíce po dnech,
do roku po týdnech a dál po měsících. Výpadek je pak vidět zhruba od dvou oken, s historií
nad dva roky tedy od 2 měsíců.

**Vše** zobrazuje nanejvýš posledních 5 let a pod oběma grafy to připomíná poznámka. Začíná
prvním dnem měsíce, který byl před 60 měsíci, takže když databáze běží 5 let a 1 měsíc,
zmizí z grafů i tabulek celý první měsíc. Starší měření v databázi zůstávají, jen se
nezobrazují; nic se nemaže samo, smaže je až tlačítko pro smazání historie.

Podnadpis **Napájení** ukazuje, za jak dlouhé okno se právě průměruje, podnadpis **Snášky**
součet vajec za zobrazený rozsah.

**Panel.** Do průměru se počítají jen hodnoty ze dne. V noci panel nedává nic a tyhle nuly by
průměr srazily na zlomek skutečnosti — u ročního pohledu, kde je jeden bod celý den, by graf
ukazoval napětí, jaké panel nikdy neměl. Kde ale do jednoho bodu padne celá noc a nic jiného,
zůstává nula, takže u krátkých rozsahů jsou noci v grafu dál vidět. Baterie se průměruje celá,
té napětí drží i v noci. Stránka na to pod grafem upozorňuje, kdykoli se průměruje po hodině
a déle.

**Snáška.** Počítá se jen přírůstek — když vejce sesbíráte, počet v hnízdě klesne, ale snáška
zůstane. Kontrola v celou hodinu hlásí vejce snesená za uplynulou hodinu, proto se kontrola
v 10:00 započítá do sloupce 9:00–10:00. Dnešek, tento týden a tento měsíc jsou ve sloupcích
vidět od první kontroly a doplňují se průběžně. Popisek sloupce ukazuje, ve kterých hnízdech
vejce přibyla.

**Časová osa.** Popisky leží vždy na kulatých hodnotách — celé minuty a hodiny, půlnoc,
pondělí, první den měsíce nebo roku — a jejich hustota se řídí šířkou grafu, aby se
nepřekrývaly. Když osa ukazuje hodiny, je místo půlnoci datum. U Vše s pěti lety jsou
na počítači i na telefonu popisky po letech, u kratší historie podle šířky po měsících nebo
letech.

### Když data chybí

**Výpadek spojení.** Kurník se ozývá každých 10 minut. Když zpráva nedorazí, neuloží se nic:
**v grafu vznikne díra široká jako výpadek** a v tabulce chybí řádky, takže se výpadek pozná
skokem v časovém sloupci. Jedna ztracená zpráva graf nepřeruší — čára se spojí, dokud mezera
nepřeroste dvě okna zvoleného rozsahu; od kdy je díra vidět, ukazuje tabulka v části
**Snáška a Napájení**. V tabulce zmizí řádek, jakmile je celé okno bez měření — v rozsazích
do 24 hodin tedy i po jediné ztracené zprávě.

**Zatím žádná data.** Tuhle hlášku ukáže karta místo grafu, když ve zvoleném rozsahu není nic
k zobrazení, a to každá karta zvlášť. U **Napájení** to znamená, že za celý rozsah nedorazila
jediná zpráva: kurník ještě nic neposlal, historie se právě smazala, nebo výpadek trvá déle
než zvolený rozsah — rozsah 6 h pak hlásí tohle, delší rozsahy ukážou starší data s dírou na
konci. **Snáška** ji ukáže, když za celý rozsah nepřišel ani jeden počet vajec: z týchž
důvodů, nebo protože žádné hnízdo počet neposílá (váha není zkalibrovaná, má poruchu, hnízdo
neodpovídá nebo na něm sedí kvočna), nebo se hnízda delší dobu nekontrolují kvůli kriticky
vybité baterii či vypnuté automatice. V rozsazích 6 h a 24 h ukazuje Snáška jen hodiny, které
už skončily, takže první počet po zapnutí kurníku se v ní objeví až po další celé hodině,
i když karta Hnízda ho ukazuje hned. Napájení tak může mít data a Snáška zároveň hlásit
**Zatím žádná data**, typicky než se váhy zkalibrují. Sloupce s nulou hlášku nevyvolají —
nula znamená, že kontrola proběhla a nic nepřibylo.

**Chybějící hodnota.** Zpráva může dorazit i bez některé hodnoty, když se čidlo neozve nebo
naměří nesmysl (baterie mimo rozsah 1–10 V, panel nad rozsah převodníku, asi 13 V). Dlaždice
pak ukáže pomlčku a oranžové **⚠ čidlo neodpovídá**, v tabulce je pomlčka v tom sloupci
a v grafu se přeruší jen ta jedna čára — druhá pokračuje dál. V delších rozsazích taková
hodnota zmizí beze stopy, protože se do průměru okna nepočítá.

**Panel na nule.** Odpojený, zastíněný nebo rozbitý panel čidlo hlásit umí: naměří 0,00 V.
Denní hrb v grafu proto klesne na nulu a v tabulce je `0,00 V`, ne pomlčka. Pomlčka u panelu
znamená, že selhalo samotné měření, ne že panel nic nedává.

**Odpojená baterie.** Z baterie běží celý kurník, takže přestanou chodit zprávy a na stránce
je to obyčejný výpadek. Pomlčka u baterie znamená, že kurník běží dál, jen se neozval senzor
INA226; v takovém případě kurník pro jistotu odpojí i panel a dvířka se do dalšího úspěšného
měření neřídí sluncem.

**Horní mez rozsahu.** Poznámka **na horní mezi rozsahu** se objeví, když hodnota dojede na
konec toho, co se vejde do zprávy — 8,00 V u baterie a 12,50 V u panelu. Skutečné napětí může
být vyšší, dlaždice, graf i tabulka ukazují tuhle mez.

**Pomlčky ve Snášce.** Tabulka Snášky ukazuje, kolik vajec v každém intervalu přibylo:

| V buňce | Co znamená |
|---|---|
| číslo, třeba **2** | přibyla dvě vejce |
| **0** | kontrola proběhla a nic nepřibylo |
| **–** | nevíme — za ten interval nepřišel žádný počet |

Pomlčka tedy neznamená nulu, ale to, že se počet nezjistil. Jsou dva případy:

- **Pomlčka v celém řádku:** z kurníku za tu dobu nepřišla žádná zpráva o hnízdech. Buď
  vypadlo spojení, nebo se hnízda vůbec nekontrolovala, protože byla baterie kriticky vybitá
  nebo byla vypnutá automatika. Karta Hnízda mezitím zůstane u poslední kontroly a její čas
  je v záhlaví karty.
- **Pomlčka jen u jednoho hnízda:** zpráva přišla, ale tohle hnízdo počet neposlalo — sedí na
  něm kvočna, váha není zkalibrovaná, má poruchu nebo neodpovídá. Sloupec **Celkem** pak
  sčítá jen ostatní hnízda.

Ve sloupcích po dnech, týdnech a měsících je pomlčka, jen když za celý den, týden nebo měsíc
nepřišel ani jeden počet.

V grafu vypadá interval s pomlčkou stejně jako nula, tedy bez sloupce; rozdíl ukáže popisek
sloupce: u nuly **Celkem: 0 vajec**, u pomlčky v celém řádku **Bez dat**. Když chybí jen
některá hnízda, je v popisku pod součtem řádek, která to jsou, třeba **Bez dat: hnízdo 2**
nebo **Bez dat: hnízda 1, 3 a 4**.

Vejce snesená během výpadku se neztratí: první kontrola po něm porovná počet s posledním
známým a celý přírůstek připíše svému intervalu, takže po výpadku bývá jeden vyšší sloupec.
Stejně se projeví vejce, která přibyla, zatímco na hnízdě seděla kvočna nebo hnízdo
neodpovídalo. Přijde se jen o vejce, která se během výpadku stihla sesbírat, a o vejce nad
deset v plném košíku, protože víc se do zprávy nevejde.

## Ovládání

Pod grafy je karta **Ovládání** se čtyřmi dvojicemi tlačítek:

| Tlačítka | Co dělají |
|---|---|
| **Otevřít**, **Zavřít** | pohnou dvířky |
| **Odblokovat**, **Zablokovat** | zablokovaná dvířka stojí — nepohnou se podle slunce ani na **Otevřít** či **Zavřít** a dlaždice ukazuje **Porucha**; **Odblokovat** zruší zablokování i skutečnou poruchu |
| **Zapnout**, **Vypnout** | vypnutá automatika zastaví dvířka podle slunce i každohodinovou kontrolu hnízd; **Otevřít**, **Zavřít**, **Vynulovat** a **Kalibrovat** fungují dál |
| **Vynulovat**, **Kalibrovat** | nastaví váhu ve vybraných hnízdech, viz **Kalibrace váhy** |

Při východu slunce a hodinu po západu se dvířka ovládají sama; ruční **Otevřít** nebo
**Zavřít** platí jen do nejbližší takové změny. Při vypnuté automatice se dvířka sama
nepohnou a zůstanou tam, kam je naposledy poslalo **Otevřít** nebo **Zavřít**, třeba
otevřená přes noc. Po odblokování nebo zapnutí automatiky dvířka hned dojedou tam, kde mají
podle slunce být, pokud ve stejné zprávě nejde i **Otevřít** nebo **Zavřít** (viz **Fronta
příkazů**). Vypnutí i zablokování si kurník pamatuje i po odpojení baterie.

> **Příkaz se neprovede hned.** Kurník kvůli úspoře baterie poslouchá jen krátce po každé
> své zprávě, takže může trvat **až 10 minut**, než se dvířka pohnou. Není to porucha
> a opakované klikání nepomůže — dokud příkaz čeká ve frontě, stránka ho podruhé nepřijme.

### Fronta příkazů

Pod tlačítky je řádek **Ve frontě** s příkazy, které ještě čekají na doručení, a pod ním
počítadlo **Zprávy s příkazy za posledních 24 h** (viz **Denní limit příkazů**). Zařazený
příkaz stránka potvrdí hláškou **Zařazeno do fronty**.

Z každé dvojice (**Otevřít**/**Zavřít**, **Odblokovat**/**Zablokovat**, **Zapnout**/**Vypnout**)
může ve frontě čekat jen jeden příkaz a pro každé hnízdo jen jedno **Vynulovat** nebo
**Kalibrovat**. Další takové kliknutí stránka odmítne hláškou **Nezařazeno, ve frontě už
čeká** a vypíše, co čeká; kdo si to rozmyslí, frontu nejdřív zruší. Výjimkou je stejný příkaz
pro další hnízda: čeká-li třeba **Vynulovat** pro hnízdo 1 a zadáte **Vynulovat** pro všechna
hnízda, čekající příkaz se nahradí jedním pro všechna hnízda dohromady.

Ostatní příkazy se k tomu, co už ve frontě čeká, přidají a odejdou do kurníku **jednou
zprávou**; stránka k hlášce připíše **sloučeno s čekajícím příkazem do jedné zprávy**. Kurník
je provede v pevném pořadí — blokace, automatika, dvířka, váhy. **Odblokovat** a **Otevřít**
tak nejdřív odblokuje, pak otevře, a **Zapnout** a **Otevřít** nejdřív zapne automatiku a pak
otevře, takže dvířka zůstanou otevřená do nejbližší změny podle slunce. Výjimkou je
**Vynulovat** a **Kalibrovat** pro různá hnízda, které se do jedné zprávy nevejdou a pošlou se
po sobě. Sloučený příkaz platí 30 minut od posledního přidání.

Tlačítko **Zrušit** smaže celou frontu najednou — pokud se to stihne dřív, než se kurník
ozve, neprovede se nic. Jednotlivý příkaz zrušit nejde; ty, které mají zůstat, je potřeba
zadat znovu. Když indikátor v záhlaví hlásí **TTN odpojeno**, nejde příkaz zařadit ani frontu
zrušit.

Jakmile brána příkaz vyšle, zmizí z fronty a stránka ohlásí **Příkaz odeslán do kurníku, čeká
na potvrzení**. Kurník příjem potvrdí do několika sekund krátkou zprávou, kterou kvůli tomu
pošle hned, a stránka ohlásí **Kurník příkaz přijal**. Dvířka se pohnou a váhy nastaví hned
potom. Když potvrzení nedorazí, stránka ohlásí **Kurník příjem nepotvrdil, příkaz se pošle
znovu** a příkaz se sám vrátí do fronty. Pokud ho kurník mezitím už provedl a ztratilo se jen
potvrzení, podruhé ho neprovede — dvířka se tak znovu nepohnou a váha se znovu nevynuluje ani
nezkalibruje. Platí to i po resetu kurníku. Jen když mezitím zadáte opačný příkaz nebo příkaz
pro stejné hnízdo, platí ten novější: nepotvrzený se znovu neposílá a stránka ohlásí
**Nepotvrzený příkaz se znovu nepošle**. Když se kurník restartuje dřív, než příkaz potvrdí,
třeba po odpojení baterie, server příkaz už znovu neposílá a stránka ohlásí **Kurník se
restartoval dřív, než příkaz potvrdil**. Zkontrolujte stav a příkaz případně zadejte znovu.

Když se příkaz do kurníku nedostane do **30 minut**, třeba protože nejde brána, internet
nebo kurník, z fronty sám zmizí a stránka ohlásí **Příkaz vypršel a neprovede se**. Stáří
příkazu hlídá i kurník, takže starší příkaz neprovede, ani kdyby ho síť doručila později.
Dvířka se tak neotevřou v noci podle příkazu zadaného odpoledne. Když síť zprávu do kurníku
vůbec nedokáže vyslat, stránka ohlásí **Příkaz se nepodařilo doručit** a příkaz z fronty také
zmizí. Kdo ho chce provést, zadá ho znovu.

> Při restartu serveru se fronta smaže i v síti, takže příkazy, které do kurníku ještě
> nedorazily, je potřeba zadat znovu. Restart serveru také odhlásí všechna otevřená okna
> a stránka se sama vrátí na přihlášení.

### Denní limit příkazů

Do kurníku jde za posledních 24 hodin poslat nejvýš **7 zpráv s příkazy**. Síť The Things
Network dovoluje jednomu zařízení 10 zpráv do kurníku denně, dvě z nich si každý den vezme
kurník na seřízení hodin a jedna zůstává jako rezerva.

Počítá se zpráva, ne tlačítko — co se sloučí do jedné zprávy, spotřebuje jedno místo, ať je
v ní příkazů kolik chce. Vyplatí se proto zadat všechno potřebné, dokud první příkaz čeká
ve frontě.

| Co se stane | Kolik míst to stojí |
|---|---|
| příkaz do prázdné fronty | jedno |
| příkaz, který se přidá k čekající zprávě, třeba **Otevřít** k čekajícímu **Odblokovat** nebo **Vynulovat** pro další hnízda k čekajícímu **Vynulovat** | žádné další |
| **Vynulovat**, když čeká **Kalibrovat** pro jiná hnízda, nebo naopak | jedno, jde samostatnou zprávou |
| zpráva, kterou kurník nepotvrdil a posílá se znovu | jedno za každé opakování |
| příkaz, který stránka odmítne (**Nezařazeno**) | žádné |

Zpráva se započítá hned, jak se zařadí do fronty. Dokud čeká, místo se zase uvolní, když
frontu zrušíte, když zpráva vyprší, když ji síť nedokáže vyslat a při restartu serveru, který
frontu smaže. Zpráva, kterou brána vyslala, zůstává započítaná celých 24 hodin, i když ji
kurník neprovedl — třeba **Otevřít** u zablokovaných dvířek nebo **Vynulovat** při kriticky
vybité baterii.

Počítadlo pod frontou ukazuje, kolik z limitu je využito, třeba **Zprávy s příkazy za
posledních 24 h: 3 z 7**. Když je limit vyčerpaný, změní se na **Limit 7 zpráv s příkazy
za 24 h je vyčerpán** s časem, od kdy půjde poslat další — to je 24 hodin po nejstarší
vyslané zprávě. Do té doby stránka nepřijme příkaz, pro který by byla potřeba nová zpráva;
příkaz, který se přidá k čekající zprávě, přijme i tak. Dvířka se mezitím dál otevírají
a zavírají sama podle slunce. Limit si server pamatuje v databázi, takže platí i po jeho
restartu.

Kolik míst zabere nastavení vah ve více hnízdech, ukazuje příklad v části **Kalibrace váhy**.

### Kalibrace váhy

Každé hnízdo váží vlastní tenzometr a ten je potřeba po montáži nastavit — dokud se to
nestane, hlásí hnízdo **⚠ váha není zkalibrovaná**. Stačí k tomu závaží o hmotnosti přesně
1 kg; jinou hmotnost by bylo potřeba změnit ve firmwaru (`NESTS_CALIB_MASS_G` v souboru
`Master/Core/Inc/nests.h`).

1. Z hnízd vyndejte všechna vejce a podestýlku nechte, jak bude normálně.
2. V **Ovládání** klikněte pod **Váha hnízd** na **Vyberte hnízda**. Otevře se okno se
   seznamem; zaškrtněte hnízda, která chcete nastavit, a klikněte na **Potvrdit**. Tlačítko
   pak ukazuje, co je vybrané (třeba **Hnízdo 2** nebo **Všechna hnízda**), a teprve teď
   jde kliknout na **Vynulovat**. Výběr zůstává, dokud ho nezměníte.
3. Počkejte, až stránka ohlásí **Kurník příkaz přijal** a karta Hnízda ukáže novou
   kontrolu s poznámkou **⚠ váha není zkalibrovaná**. Kurník zaškrtnutá hnízda vynuluje hned po přijetí příkazu, nečeká na celou
   hodinu; ostatní hnízda přitom změří stejně jako při hodinové kontrole.
4. Do každého z nich položte doprostřed závaží a klikněte na **Kalibrovat**. Kdo má jen
   jedno závaží, kalibruje hnízda po jednom. Závaží smí být jen v hnízdech, která se právě
   kalibrují: ostatní hnízda kurník při tom změří a závaží by v nich započítal jako vejce.
5. Až se karta Hnízda znovu obnoví, závaží sundejte.

Každý z obou kroků může trvat až deset minut, protože příkaz čeká, až se kurník ozve.
Jedním příkazem jde nastavit libovolný počet hnízd. **Vynulovat** a **Kalibrovat** pro
různá hnízda se do jedné zprávy nesloučí, takže se do kurníku dostávají po jednom, další
vždy pár sekund po potvrzení předchozího. Každý takový příkaz spotřebuje jedno místo
z denního limitu: vynulovat všechna hnízda najednou je jeden příkaz, ale kalibrace pěti
hnízd s jedním závažím je pět dalších. Když limit nestačí, dokončete kalibraci další den.
Hnízdo během kalibrace nesmí obsadit slepice — nejlepší je kalibrovat večer, kdy jsou
slepice zavřené na hřadu.

Hnízdo, které ještě nikdy nebylo vynulované (karta u něj ukazuje
**⚠ váha není zkalibrovaná, nejdřív ji vynulujte**), stránka kalibrovat nedovolí a napíše
**Nezařazeno: hnízdo 2 ještě není vynulované**; příkaz se neodešle, takže nespotřebuje ani
místo v denním limitu. Kdyby se do kurníku přesto dostal, hnízdo ho jen zahodí a dál hlásí
nevynulovanou váhu.

Jednou vynulované hnízdo jde později znovu kalibrovat i bez nového vynulování, pokud je
prázdné a nezměnila se podestýlka ani košík. Naopak po výměně podestýlky nebo posunutí
košíku stačí hnízdo jen vynulovat, kalibrace zůstává platná. Drobné změny do 25 g dorovnává
kurník sám jednou denně, když je hnízdo prázdné; větší změna by se jinak počítala jako vejce.

Vynulování i kalibrace proběhnou jen hned po přijetí, nikdy později — jinak by se mohly
provést, až bude v hnízdě vejce nebo už nebude závaží. Je-li baterie kriticky vybitá, kurník
příkaz zahodí a karta Hnízda se neobnoví. Vypnutá automatika vynulování ani kalibraci
nebrání. Když hnízdo neodpovídá, karta ukáže **⚠ hnízdo neodpovídá**; když se vynulování nebo
kalibrace nepovede, ukáže **⚠ porucha váhy** (viz **Hnízda**). Po odstranění příčiny příkaz
pošlete znovu.

### Smazání historie

Tlačítko **Smazat** na kartě Data vyhodí všechna uložená měření. Než se to stane,
stránka se zeptá na heslo — totéž, kterým se přihlašujete; samotné přihlášení k tomuhle
kroku nestačí. Když není co mazat, tlačítko je neaktivní.

> **Nedá se to vrátit.** Dlaždice se vyprázdní, graf zůstane bez dat a vrátit je jde jen
> ze zálohy. Zálohování je popsané v kapitole 6.

Kurníku se to nijak nedotkne: posílá dál a první zpráva po smazání se zase uloží.

## Když to nejede

**Brána není Connected.** Zkontrolujte, že domácí Wi-Fi vysílá na 2,4 GHz. Pokud ano, podržte
SETUP a nastavte ji znovu. Ujistěte se také, že byl použit **Claim gateway**, ne Register gateway.

**Kurník se nepřipojí, v konzoli je `MIC mismatch`.** AppKey v konzoli nesouhlasí s tím
v kurníku. Opravte ho u zařízení v **General settings → Join settings** a kurník vypněte a zapněte.

**Stránku nelze najít.** Zkuste místo `kurnik.local` přímo IP adresu Pi (kapitola 7,
**Adresa Pi**). Pokud prohlížeč přepíná na HTTPS, vypněte v něm „Vždy používat zabezpečené
připojení". A ověřte, že zařízení je na stejné Wi-Fi jako Pi — ze sítě pro hosty nebo
z mobilních dat se na něj nedostanete.

**Přihlášení hlásí příliš mnoho pokusů.** Po pěti špatných heslech se přihlašování na 15 minut
zamkne. Buď je potřeba počkat, nebo zámek zruší restart: `docker compose restart app`.

**V konzoli jsou zprávy, ale stránka je prázdná.** Zkontrolujte `TTN_APP_ID`, `TTN_DEVICE_ID`
a `TTN_API_KEY` v souboru `.env`, pak `docker compose up -d`. Ve výpisu `docker compose logs app`
musí být `TTN connected`.

**Databáze hlásí chybu.** Podívejte se do výpisu `docker compose logs app`. Když je
soubor s daty poškozený (třeba po vytažení karty za běhu), obnovte ho ze zálohy; pokud
žádná není, smažte ho a databáze se založí prázdná znovu:

```bash
docker compose down
docker volume rm server_coop-data
docker compose up -d
```

Když hláška končí `database or disk is full` a nahoře svítí **Plná databáze**, na kartě došlo
místo. Kurník se dál ozývá
a dlaždice se obnovují, jen se nová měření neukládají a v grafu po nich zůstane díra.
Uložená data zůstanou v pořádku a jakmile se místo uvolní, server začne zase ukládat sám,
bez restartu. Automatika, kterou mezitím přepnete, ukáže pomlčku; po uvolnění místa se
uloží a dlaždice ukáže skutečný stav. Jen když se server s plnou kartou restartuje, skutečný
stav nezná — pomlčka pak zůstane, dokud nepošlete **Zapnout** nebo **Vypnout**. Volné místo ukáže `df -h /`. Měření zaberou asi 4 MB za rok, takže kartu
zaplní spíš něco jiného — nejčastěji staré obrazy serveru, které po každé aktualizaci
s `--build` zůstávají na kartě. Ty uvolní `docker image prune`; data se tím nesmažou.

**Stránka hlásí vyčerpaný limit příkazů.** Za posledních 24 hodin už do kurníku odešlo
7 zpráv s příkazy (kapitola **Ovládání**, **Denní limit příkazů**). Počkejte do času, který
stránka uvádí; mezitím kurník dál otevírá a zavírá dvířka sám podle slunce.

**Dvířka hlásí poruchu.** Něco jim překáží, nebo nedojela do koncové polohy. Odstraňte
překážku a klikněte na **Odblokovat**. Porucha se sama nezruší ani po vypnutí napájení.

**Hnízdo neodpovídá.** Zkontrolujte datový kabel do jeho krabičky a do krabiček před ním —
když se neozve jedno hnízdo, neozvou se ani všechna za ním. Pak ověřte, že `NEST_COUNT`
v `.env` sedí s `NESTS_COUNT` ve firmwaru a že řadič v krabičce má správnou adresu.
