Hosty-04/ChickenCoop/Plots/panel_characteristic.xlsx

U [V] | I [A] | P [W]
0.0 | 1.23 | 0.00
0.5 | 1.23 | 0.61
1.0 | 1.23 | 1.23
1.5 | 1.23 | 1.84
2.0 | 1.23 | 2.46
2.5 | 1.23 | 3.07
3.0 | 1.23 | 3.69
3.5 | 1.23 | 4.30
4.0 | 1.23 | 4.92
4.5 | 1.23 | 5.53
5.0 | 1.23 | 6.15
5.5 | 1.23 | 6.76
6.0 | 1.23 | 7.37
6.5 | 1.23 | 7.98
7.0 | 1.22 | 8.56
7.5 | 1.22 | 9.12
8.0 | 1.20 | 9.60
8.5 | 1.17 | 9.93
9.0 | 1.11 | 9.99
9.5 | 1.01 | 9.55
10.0 | 0.82 | 8.23
10.5 | 0.51 | 5.39
11.0 | 0.00 | 0.00
