Hosty-04/ChickenCoop/Plots/panel_characteristic_white.png

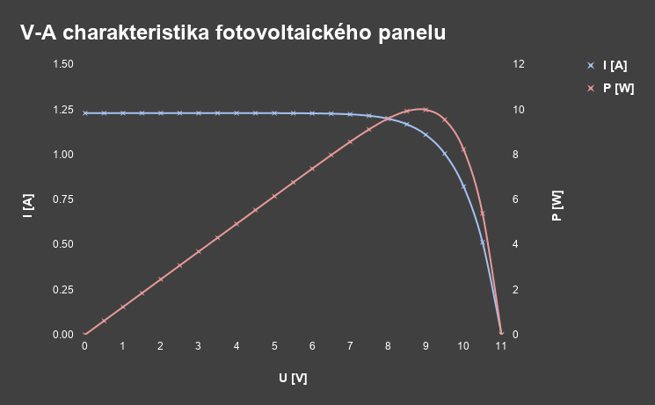
Plots/panel_characteristic_white.png
