Hosty-04/ChickenCoop/NestPCB/NestPCB.kicad_pcb

## KiCad design NestPCB/NestPCB.kicad_pcb (2026-11-14)

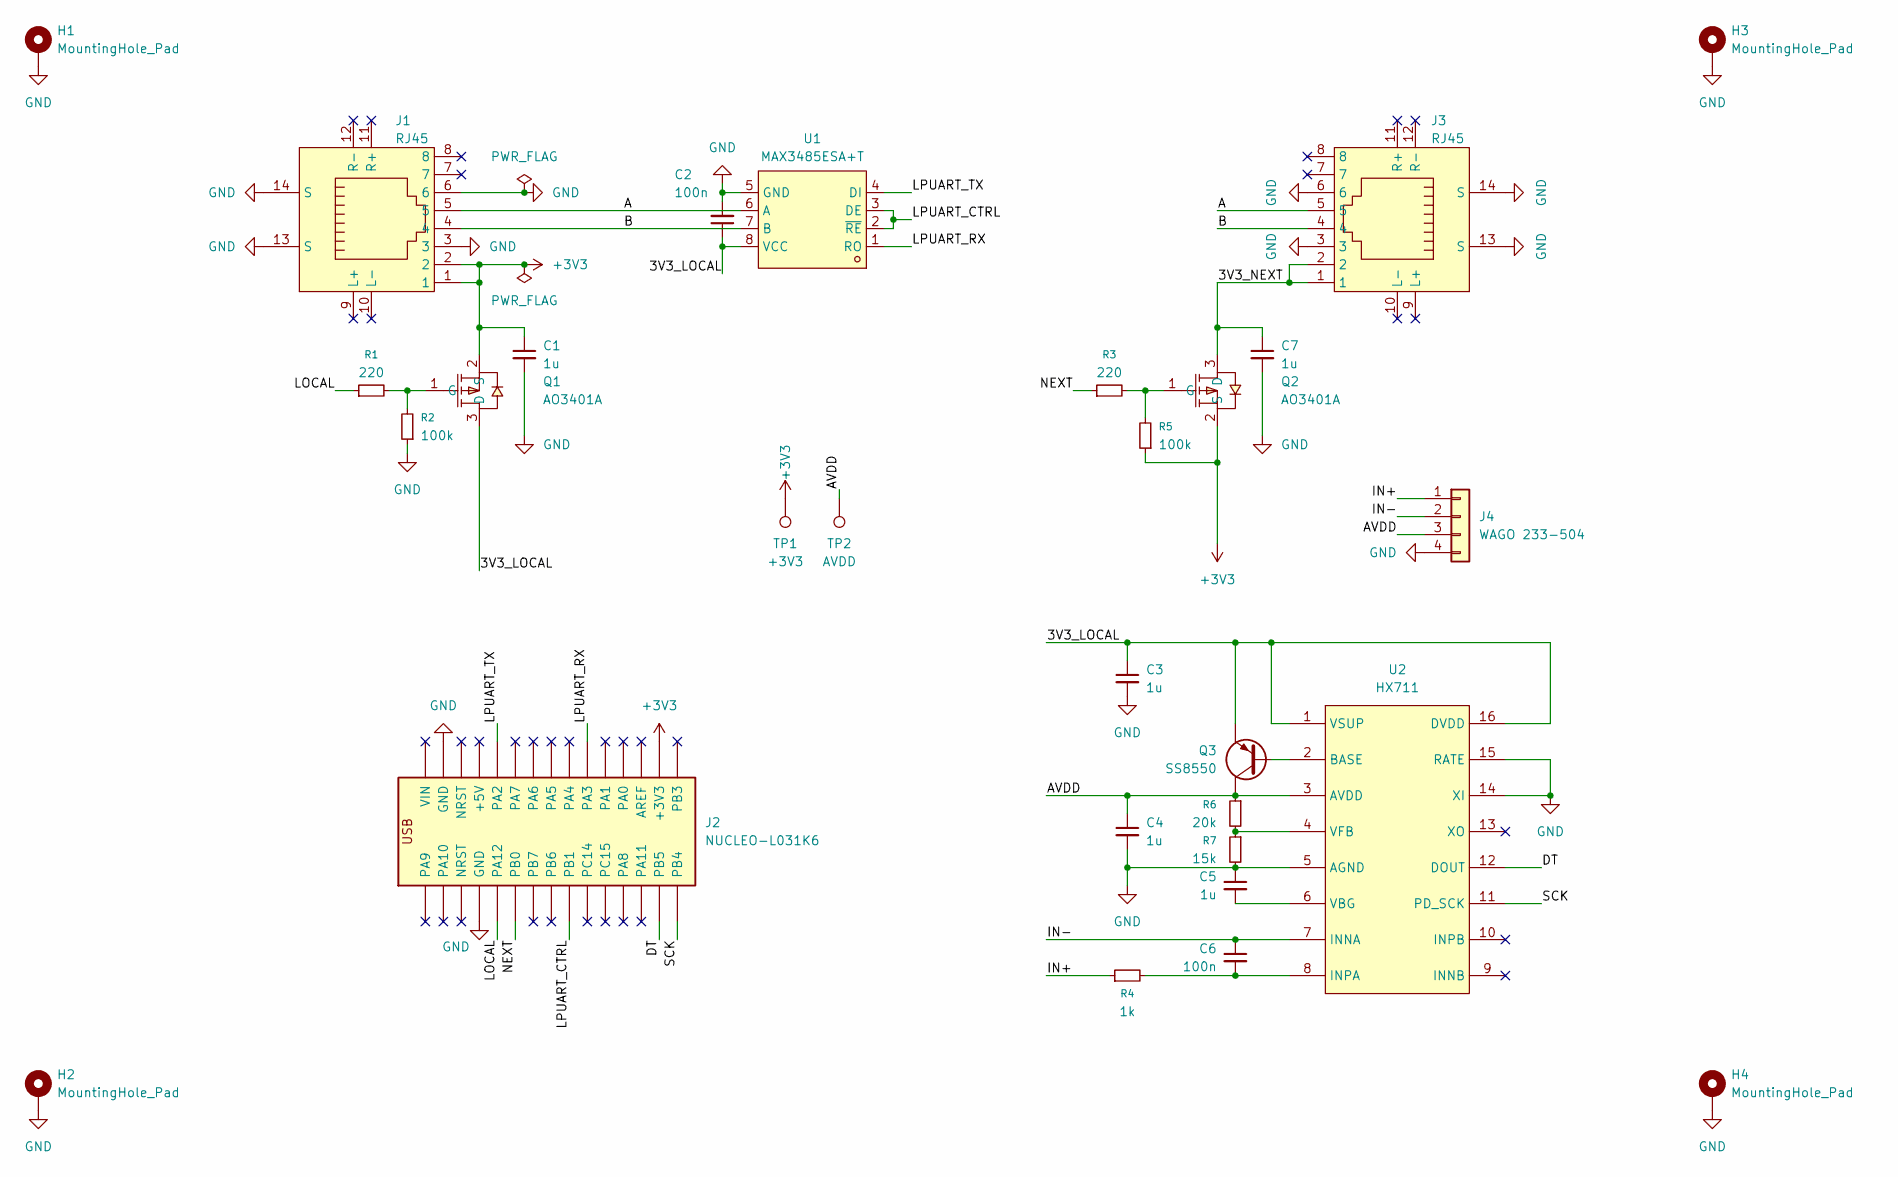
[picture p25: schematic NestPCB.kicad_sch, Chicken Coop]

Parts:
C1, C3, C4, C5, C7: 1u; C_0805_2012Metric
C2, C6: 100n; C_0805_2012Metric
H1, H2, H3, H4: MountingHole_Pad; MountingHole_3.2mm_M3_Pad
J1, J3: RJ45; RJ45-TH_R-RJ45R08P-C000; MPN R-RJ45R08P-C000; LCSC Part C386757
J2: NUCLEO-L031K6
J4: WAGO 233-504; CONN-TH_233-504
Q1, Q2: AO3401A; SOT-23_L2.9-W1.3-P1.90-LS2.4-BR; MPN AO3401A; LCSC Part C15127
Q3: SS8550; SOT-23-3_L2.9-W1.3-P1.90-LS2.4-BR; MPN SS8550 Y2(RANGE:200-350); LCSC Part C8542
R1, R3: 220; R_0805_2012Metric
R2, R5: 100k; R_0805_2012Metric
R4: 1k; R_0805_2012Metric
R6: 20k; R_0805_2012Metric
R7: 15k; R_0805_2012Metric
TP1: +3V3; TestPoint_THTPad_D2.0mm_Drill1.0mm
TP2: AVDD; TestPoint_THTPad_D2.0mm_Drill1.0mm
U1: MAX3485ESA+T; SOIC-8_L4.9-W3.9-P1.27-LS6.0-BL; MPN MAX3485ESA+T; LCSC Part C18148
U2: HX711; SOP-16_L10.0-W3.9-P1.27-LS6.0-BL; MPN HX711; LCSC Part C43656

Connections:
+3V3: C1.1, J1.1, J1.2, J2.CN4-14 (+3V3), Q1.2 (S), Q2.2 (S), R5.1, TP1.1
/3V3_LOCAL: C2.1, C3.1, Q1.3 (D), Q3.2 (E), U1.8 (VCC), U2.1 (VSUP), U2.16 (DVDD)
/3V3_NEXT: C7.1, J3.1, J3.2, Q2.3 (D)
/A: J1.5, J3.5, U1.6 (A)
/AVDD: C4.1, J4.3, Q3.3 (C), R6.1, TP2.1, U2.3 (AVDD)
/B: J1.4, J3.4, U1.7 (B)
/DT: J2.CN3-14 (PB5), U2.12 (DOUT)
/IN+: J4.1, R4.1
/IN-: C6.1, J4.2, U2.7 (INNA)
/LOCAL: J2.CN3-5 (PA12), R1.1
/LPUART_CTRL: J2.CN3-9 (PB1), U1.2 (~RE), U1.3 (DE)
/LPUART_RX: J2.CN4-10 (PA3), U1.1 (RO)
/LPUART_TX: J2.CN4-5 (PA2), U1.4 (DI)
/NEXT: J2.CN3-6 (PB0), R3.1
/SCK: J2.CN3-15 (PB4), U2.11 (PD_SCK)
GND: C1.2, C2.2, C3.2, C4.2, C5.1, C7.2, H1.1, H2.1, H3.1, H4.1, J1.3, J1.6, J1.13 (S), J1.14 (S), J2.CN3-4 (GND), J2.CN4-2 (GND), J3.3, J3.6, J3.13 (S), J3.14 (S), J4.4, R2.1, R7.2, U1.5 (GND), U2.5 (AGND), U2.14 (XI), U2.15 (RATE)
unnamed: Q1.1 (G), R1.2, R2.2
unnamed: Q2.1 (G), R3.2, R5.2
unnamed: Q3.1 (B), U2.2 (BASE)
unnamed: C6.2, R4.2, U2.8 (INPA)
unnamed: C5.2, U2.6 (VBG)
unnamed: R6.2, R7.1, U2.4 (VFB)

Board: 2 copper layers, 29 parts (0 on the bottom side), 22 nets, no tracks yet.
