Hosty-04/ChickenCoop/MainPCB/PCB.kicad_pcb

## KiCad design MainPCB/PCB.kicad_pcb (2026-11-14)

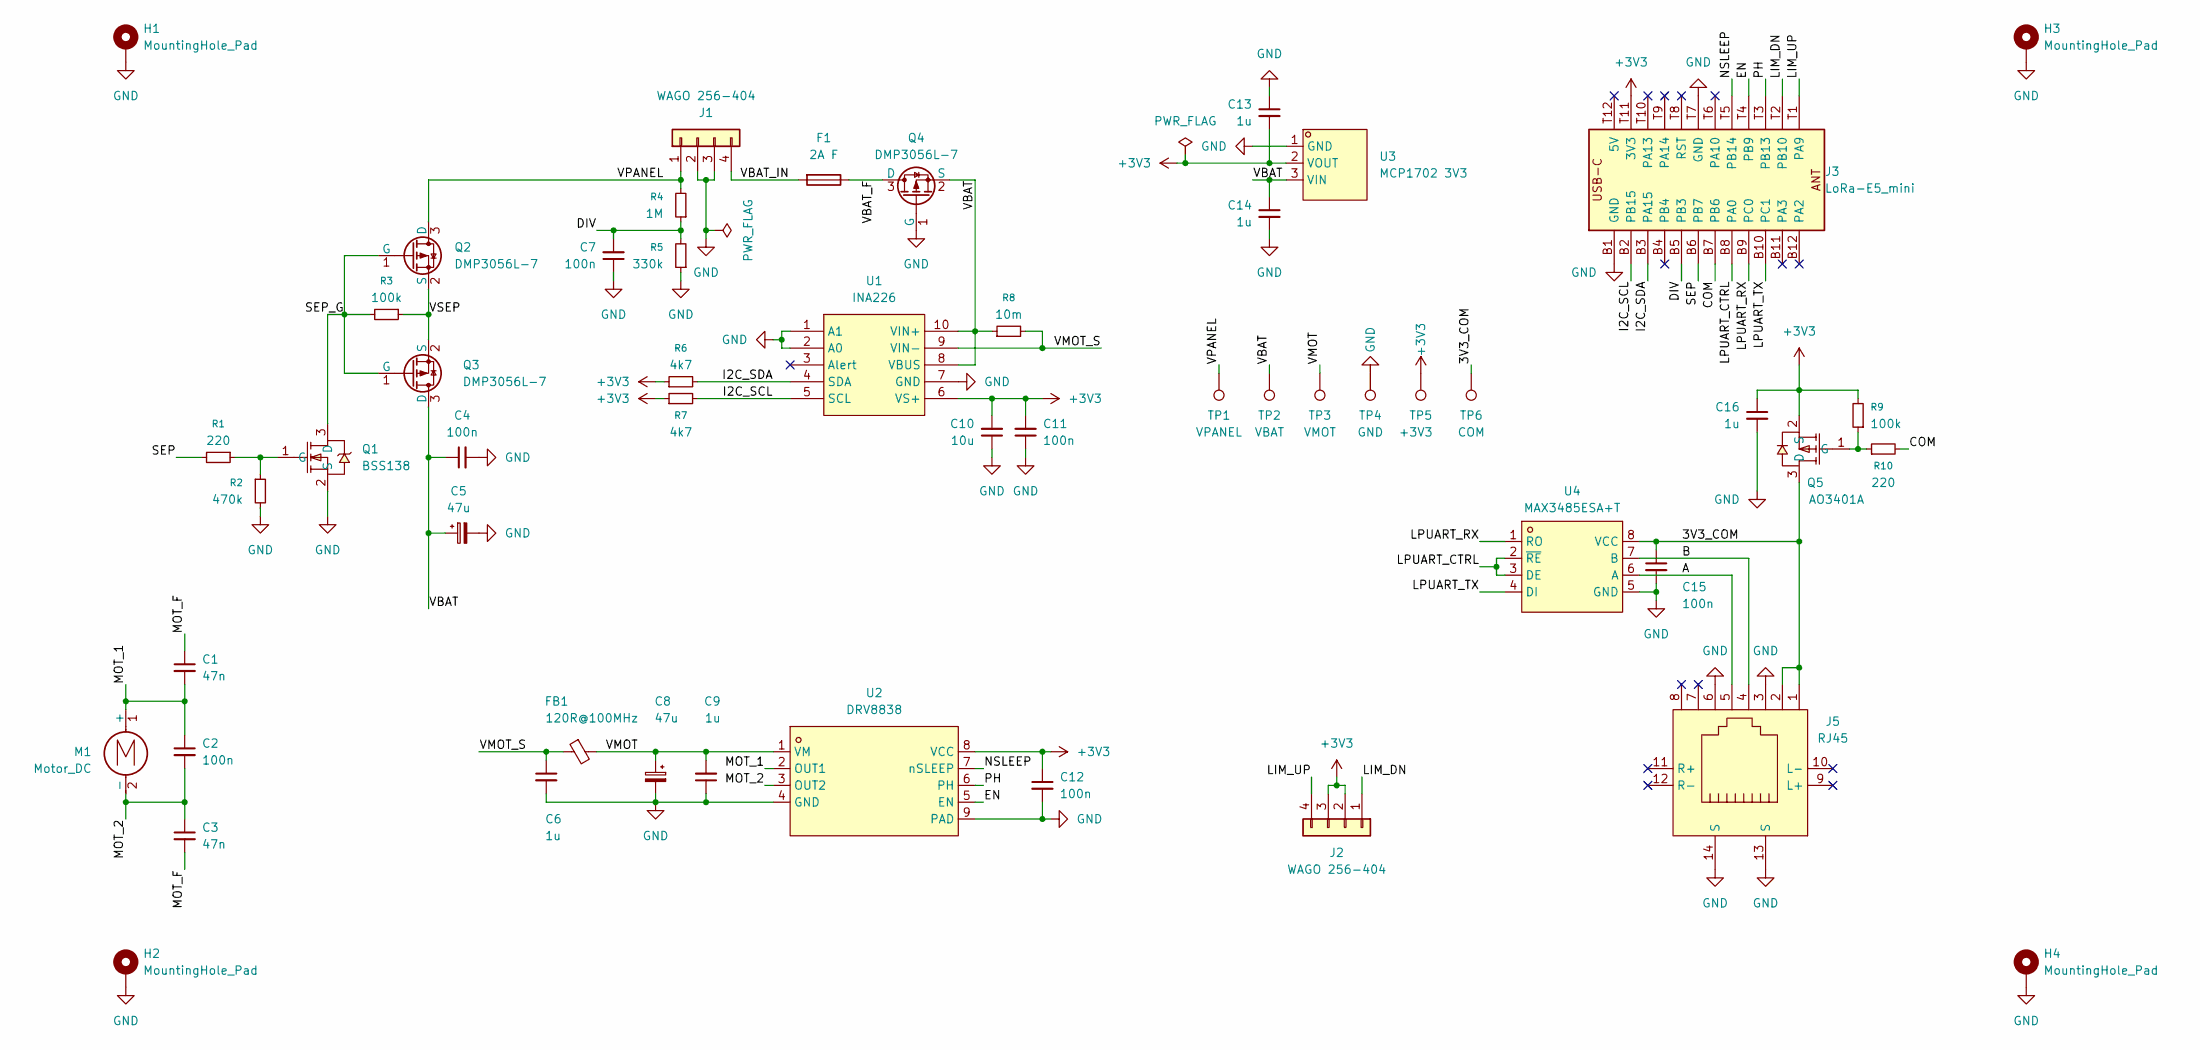
[picture p26: schematic PCB.kicad_sch, Chicken Coop]

Parts:
C1, C3: 47n; C_0805_2012Metric
C2, C4, C7, C11, C12, C15: 100n; C_0805_2012Metric
C5, C8: 47u; CP_Elec_6.3x5.8
C6, C9, C13, C14, C16: 1u; C_0805_2012Metric
C10: 10u; C_0805_2012Metric
F1: 2A F; FUSE-TH_L22.0-W9.0-P22.60
FB1: 120R@100MHz; L_0805_2012Metric
H1, H2, H3, H4: MountingHole_Pad; MountingHole_3.2mm_M3_Pad
J1, J2: WAGO 256-404; CONN-TH_4P-P5.08-256-404
J3: LoRa-E5_mini
J5: RJ45; RJ45-TH_R-RJ45R08P-C000; MPN R-RJ45R08P-C000; LCSC Part C386757
M1: Motor_DC; Pololu_MicroMotor_Bracket
Q1: BSS138; SOT-23-3_L2.9-W1.6-P1.90-LS2.8-BR; MPN BSS138; LCSC Part C52895
Q2, Q3, Q4: DMP3056L-7; SOT-23; MPN DMP3056L-7; LCSC Part C150724
Q5: AO3401A; SOT-23_L2.9-W1.3-P1.90-LS2.4-BR; MPN AO3401A; LCSC Part C15127
R1, R10: 220; R_0805_2012Metric
R2: 470k; R_0805_2012Metric
R3, R9: 100k; R_0805_2012Metric
R4: 1M; R_0805_2012Metric
R5: 330k; R_0805_2012Metric
R6, R7: 4k7; R_0805_2012Metric
R8: 10m; R_1206_3216Metric
TP1: VPANEL; TestPoint_THTPad_D2.0mm_Drill1.0mm
TP2: VBAT; TestPoint_THTPad_D2.0mm_Drill1.0mm
TP3: VMOT; TestPoint_THTPad_D2.0mm_Drill1.0mm
TP4: GND; TestPoint_THTPad_D2.0mm_Drill1.0mm
TP5: +3V3; TestPoint_THTPad_D2.0mm_Drill1.0mm
TP6: COM; TestPoint_THTPad_D2.0mm_Drill1.0mm
U1: INA226; MSOP-10_L3.0-W3.0-P0.50-LS5.0-BL; MPN INA226AIDGSR; LCSC Part C49851
U2: DRV8838; WSON-8_L2.0-W2.0-P0.50-TL-EP; MPN DRV8838DSGR; LCSC Part C86667
U3: MCP1702 3V3; SOT-23-3_L2.9-W1.3-P1.90-LS2.4-BR; MPN MCP1702T-3302E/CB; LCSC Part C33844
U4: MAX3485ESA+T; SOIC-8_L4.9-W3.9-P1.27-LS6.0-BL; MPN MAX3485ESA+T; LCSC Part C18148

Connections:
+3V3: C10.2, C11.2, C12.1, C13.2, C16.1, J2.2, J2.3, J3.T11 (3V3), Q5.2 (S), R6.1, R7.1, R9.2, TP5.1, U1.6 (VS+), U2.8 (VCC), U3.2 (VOUT)
/3V3_COM: C15.1, J5.1, J5.2, Q5.3 (D), TP6.1, U4.8 (VCC)
/A: J5.5, U4.6 (A)
/B: J5.4, U4.7 (B)
/COM: J3.B7 (PB6), R10.2
/DIV: C7.2, J3.B5 (PB3), R4.1, R5.2
/EN: J3.T4 (PB9), U2.5 (EN)
/I2C_SCL: J3.B2 (PB15), R7.2, U1.5 (SCL)
/I2C_SDA: J3.B3 (PA15), R6.2, U1.4 (SDA)
/LIM_DN: J2.1, J3.T2 (PB10)
/LIM_UP: J2.4, J3.T1 (PA9)
/LPUART_CTRL: J3.B8 (PA0), U4.2 (~RE), U4.3 (DE)
/LPUART_RX: J3.B9 (PC0), U4.1 (RO)
/LPUART_TX: J3.B10 (PC1), U4.4 (DI)
/MOT_1: C1.2, C2.1, M1.1 (+), U2.2 (OUT1)
/MOT_2: C2.2, C3.1, M1.2 (-), U2.3 (OUT2)
/NSLEEP: J3.T5 (PB14), U2.7 (nSLEEP)
/PH: J3.T3 (PB13), U2.6 (PH)
/SEP: J3.B6 (PB7), R1.2
/SEP_G: Q1.3 (D), Q2.1 (G), Q3.1 (G), R3.2
/VBAT: C4.1, C5.1, C14.1, Q3.3 (D), Q4.2 (S), R8.1, TP2.1, U1.8 (VBUS), U1.10 (VIN+), U3.3 (VIN)
/VBAT_F: F1.1, Q4.3 (D)
/VBAT_IN: F1.2, J1.4
/VMOT: C8.1, C9.2, FB1.2, TP3.1, U2.1 (VM)
/VMOT_S: C6.1, FB1.1, R8.2, U1.9 (VIN-)
/VPANEL: J1.1, Q2.3 (D), R4.2, TP1.1
/VSEP: Q2.2 (S), Q3.2 (S), R3.1
GND: C4.2, C5.2, C6.2, C7.1, C8.2, C9.1, C10.1, C11.1, C12.2, C13.1, C14.2, C15.2, C16.2, H1.1, H2.1, H3.1, H4.1, J1.2, J1.3, J3.B1 (GND), J3.T7 (GND), J5.3, J5.6, J5.13 (S), J5.14 (S), Q1.2 (S), Q4.1 (G), R2.2, R5.1, TP4.1, U1.1 (A1), U1.2 (A0), U1.7 (GND), U2.4 (GND), U2.9 (PAD), U3.1 (GND), U4.5 (GND)
unnamed: C1.1, C3.2
unnamed: Q1.1 (G), R1.1, R2.1
unnamed: Q5.1 (G), R9.1, R10.1

Board: 2 copper layers, 49 parts (0 on the bottom side), 30 nets, no tracks yet.
