Hosty-04/ChickenCoop/Master/Core/Src/main.c

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
/* Includes ------------------------------------------------------------------*/
#include "main.h"
#include "dma.h"
#include "i2c.h"
#include "app_lorawan.h"
#include "usart_if.h"
#include "usart.h"
#include "rng.h"
#include "tim.h"
#include "gpio.h"

/* USER CODE BEGIN Includes */
#include "system.h"
#include "door.h"
#include "battery.h"
#include "nests.h"
#include "lora_app.h"
#include "power.h"
#include "sys_conf.h"
/* USER CODE END Includes */


void SystemClock_Config(void);
/**
  * @brief  The application entry point.
  * @retval int
  */
int main(void)
{

  /* MCU Configuration--------------------------------------------------------*/

  /* Reset of all peripherals, Initializes the Flash interface and the Systick. */
  HAL_Init();

  /* Configure the system clock */
  SystemClock_Config();

  /* Initialize all configured peripherals */
  MX_GPIO_Init();
  MX_DMA_Init();
  MX_I2C2_Init();
  MX_LPUART1_UART_Init();
  MX_TIM17_Init();
  MX_RNG_Init();
  MX_LoRaWAN_Init();
  /* USER CODE BEGIN 2 */

#ifndef DEBUG
  HAL_Delay(2000);
  Power_DisableDebug();  /* For a new Release: Connect the ST-LINK (Use only one 3,3 V source!), build the Release, 
                            press the RST button and within 2 secs run the "Flash Master (Release)" task */
#endif

#if (VERBOSE_LEVEL == VLEVEL_OFF)
  vcom_DeInit();
#endif

  Power_Init();

  Battery_Init();
  Door_Init();
  Door_Setup(2026, 1, 1, 0, 0, 0, COOP_LATITUDE, COOP_LONGITUDE);
  Battery_Measure();
  Nests_Init();
  if (!System_IsEnabled())
    Nests_Disable();

  /* USER CODE END 2 */

  /* Infinite loop */
  /* USER CODE BEGIN WHILE */
  while (1)
  {
    System_Process();
    LoRaWAN_SendPending();
    /* USER CODE END WHILE */
    MX_LoRaWAN_Process();

    /* USER CODE BEGIN 3 */
  }
  /* USER CODE END 3 */
}

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
