Hosty-04/ChickenCoop/Master/Master.ioc

Mcu.UserName=STM32WLE5JCIx
PA0.GPIO_Label=LPUART_CTRL
PA0.Signal=GPIO_Analog
PA13.GPIO_Label=DEBUG_SWDIO
PA13.Signal=DEBUG_JTMS-SWDIO
PA14.GPIO_Label=DEBUG_SWCLK
PA14.Signal=DEBUG_JTCK-SWCLK
PA15.GPIO_Label=I2C_SDA
PA15.Signal=I2C2_SDA
PA2.GPIO_Label=USART_TX
PA2.Signal=USART2_TX
PA3.GPIO_Label=USART_RX
PA3.Signal=USART2_RX
PA4.GPIO_Label=RF_CTRL1
PA4.Signal=GPIO_Output
PA5.GPIO_Label=RF_CTRL2
PA5.Signal=GPIO_Output
PA9.GPIO_Label=LIM_UP
PA9.Signal=GPIO_Analog
PB0-VDD_TCXO.Signal=VDDTCXO
PB10.GPIO_Label=LIM_DN
PB10.Signal=GPIO_Analog
PB13.GPIO_Label=PH
PB13.Signal=GPIO_Analog
PB14.GPIO_Label=NSLEEP
PB14.Signal=GPIO_Analog
PB15.GPIO_Label=I2C_SCL
PB15.Signal=I2C2_SCL
PB3.GPIO_Label=DIV
PB3.Signal=ADC_IN2
PB6.GPIO_Label=COM
PB6.Signal=GPIO_Output
PB7.GPIO_Label=SEP
PB7.Signal=GPIO_Output
PB9.GPIO_Label=EN
PB9.Signal=S_TIM17_CH1
PC0.GPIO_Label=LPUART_RX
PC0.Signal=LPUART1_RX
PC1.GPIO_Label=LPUART_TX
PC1.Signal=LPUART1_TX
PC14-OSC32_IN.Signal=RCC_OSC32_IN
PC15-OSC32_OUT.Signal=RCC_OSC32_OUT
