Hosty-04/ChickenCoop/Master/Core/Inc/main.h

#define RTC_N_PREDIV_S 10
#define RTC_PREDIV_S ((1<<RTC_N_PREDIV_S)-1)
#define RTC_PREDIV_A ((1<<(15-RTC_N_PREDIV_S))-1)
#define DEBUG_SWCLK_Pin GPIO_PIN_14
#define DEBUG_SWCLK_GPIO_Port GPIOA
#define I2C_SDA_Pin GPIO_PIN_15
#define I2C_SDA_GPIO_Port GPIOA
#define I2C_SCL_Pin GPIO_PIN_15
#define I2C_SCL_GPIO_Port GPIOB
#define DEBUG_SWDIO_Pin GPIO_PIN_13
#define DEBUG_SWDIO_GPIO_Port GPIOA
#define DIV_Pin GPIO_PIN_3
#define DIV_GPIO_Port GPIOB
#define COM_Pin GPIO_PIN_6
#define COM_GPIO_Port GPIOB
#define EN_Pin GPIO_PIN_9
#define EN_GPIO_Port GPIOB
#define NSLEEP_Pin GPIO_PIN_14
#define NSLEEP_GPIO_Port GPIOB
#define LPUART_CTRL_Pin GPIO_PIN_0
#define LPUART_CTRL_GPIO_Port GPIOA
#define PH_Pin GPIO_PIN_13
#define PH_GPIO_Port GPIOB
#define SEP_Pin GPIO_PIN_7
#define SEP_GPIO_Port GPIOB
#define LIM_UP_Pin GPIO_PIN_9
#define LIM_UP_GPIO_Port GPIOA
#define LPUART_TX_Pin GPIO_PIN_1
#define LPUART_TX_GPIO_Port GPIOC
#define LPUART_RX_Pin GPIO_PIN_0
#define LPUART_RX_GPIO_Port GPIOC
#define USART_RX_Pin GPIO_PIN_3
#define USART_RX_GPIO_Port GPIOA
#define USART_TX_Pin GPIO_PIN_2
#define USART_TX_GPIO_Port GPIOA
#define LIM_DN_Pin GPIO_PIN_10
#define LIM_DN_GPIO_Port GPIOB
#define RF_CTRL1_Pin GPIO_PIN_4
#define RF_CTRL1_GPIO_Port GPIOA
#define RF_CTRL2_Pin GPIO_PIN_5
#define RF_CTRL2_GPIO_Port GPIOA
#define COOP_LATITUDE   49.5170f
#define COOP_LONGITUDE  17.6181f
