Hosty-04/ChickenCoop/Master/Core/Src/timebase.c

/**
  ******************************************************************************
  * @file    timebase.c
  * @brief   Timebase helper
  ******************************************************************************
  */

#include "timebase.h"
#include "rtc.h"

#define TIMEBASE_BKP_UNIX   RTC_BKP_DR5
#define TIMEBASE_BKP_TICK   RTC_BKP_DR6
#define TIMEBASE_SAVE_S     3600UL

#define TIMEBASE_TZ_WINTER  60
#define TIMEBASE_TZ_SUMMER  120

static uint32_t unix_ref   = TIMEBASE_MIN_UNIX;
static uint32_t tick_ref   = 0;
static uint32_t saved_unix = 0;
static uint8_t  time_valid = 0;

static uint32_t cache_unix   = 0xFFFFFFFFUL;
static uint32_t cache_sod    = 0;
static uint16_t cache_year   = 0;
static uint8_t  cache_month  = 0;
static uint8_t  cache_day    = 0;
static int16_t  cache_tz_min = 0;

static void Timebase_CivilFromDays(uint32_t days, uint16_t *y_out,
                                   uint8_t *m_out, uint8_t *d_out)
{
  uint32_t z   = days + 719468U;
  uint32_t era = z / 146097U;
  uint32_t doe = z - era * 146097U;
  uint32_t yoe = (doe - doe / 1460U + doe / 36524U - doe / 146096U) / 365U;
  uint32_t doy = doe - (365U * yoe + yoe / 4U - yoe / 100U);
  uint32_t mp  = (5U * doy + 2U) / 153U;
  uint32_t d   = doy - (153U * mp + 2U) / 5U + 1U;
  uint32_t m   = (mp < 10U) ? (mp + 3U) : (mp - 9U);
  uint32_t y   = yoe + era * 400U + ((m <= 2U) ? 1U : 0U);

  *y_out = (uint16_t)y;
  *m_out = (uint8_t)m;
  *d_out = (uint8_t)d;
}

static uint8_t Timebase_LastSunday(uint16_t year, uint8_t month)
{
  static const uint8_t t[12] = {0, 3, 2, 5, 0, 3, 5, 1, 4, 6, 2, 4};
  uint16_t y  = (uint16_t)(year - ((month < 3U) ? 1U : 0U));
  uint8_t  wd = (uint8_t)((y + y / 4U - y / 100U + y / 400U + t[month - 1U] + 31U) % 7U);

  return (uint8_t)(31U - wd);
}

static int16_t Timebase_ZoneMin(uint16_t year, uint8_t month, uint8_t day, uint8_t hour_utc)
{
  uint8_t last, summer;

  if ((month < 3U) || (month > 10U)) return TIMEBASE_TZ_WINTER;
  if ((month > 3U) && (month < 10U)) return TIMEBASE_TZ_SUMMER;

  last = Timebase_LastSunday(year, month);

  if (day == last)
    summer = (uint8_t)(hour_utc >= 1U);
  else
    summer = (uint8_t)(day > last);

  if (month == 10U)
    summer = (uint8_t)!summer;

  return summer ? TIMEBASE_TZ_SUMMER : TIMEBASE_TZ_WINTER;
}

static int16_t Timebase_ZoneAt(uint32_t utc)
{
  uint16_t y;
  uint8_t  m, d;

  Timebase_CivilFromDays(utc / SECS_PER_DAY, &y, &m, &d);

  return Timebase_ZoneMin(y, m, d, (uint8_t)((utc % SECS_PER_DAY) / 3600UL));
}

static uint32_t Timebase_ToUnix(uint16_t year, uint8_t month, uint8_t day,
                                uint8_t hour, uint8_t min, uint8_t sec, int16_t tz_min)
{
  int32_t yy   = (int32_t)year - ((month <= 2U) ? 1 : 0);
  int32_t era  = yy / 400;
  int32_t yoe  = yy - era * 400;
  int32_t mp   = (month > 2U) ? ((int32_t)month - 3) : ((int32_t)month + 9);
  int32_t doy  = (153 * mp + 2) / 5 + (int32_t)day - 1;
  int32_t doe  = yoe * 365 + yoe / 4 - yoe / 100 + doy;
  int32_t days = era * 146097 + doe - 719468;
  int32_t secs = (int32_t)hour * 3600 + (int32_t)min * 60 + (int32_t)sec
               - (int32_t)tz_min * 60;

  return (uint32_t)((int64_t)days * (int64_t)SECS_PER_DAY + secs);
}

static void Timebase_Save(void)
{
  HAL_PWR_EnableBkUpAccess();
  HAL_RTCEx_BKUPWrite(&hrtc, TIMEBASE_BKP_UNIX, unix_ref);
  HAL_RTCEx_BKUPWrite(&hrtc, TIMEBASE_BKP_TICK, tick_ref);
  saved_unix = unix_ref;
}

static void Timebase_Refresh(void)
{
  uint32_t utc = Timebase_GetUnix();
  uint32_t local;

  if (utc == cache_unix)
    return;

  cache_unix   = utc;
  cache_tz_min = Timebase_ZoneAt(utc);
  local        = utc + (uint32_t)((int32_t)cache_tz_min * 60);

  Timebase_CivilFromDays(local / SECS_PER_DAY, &cache_year, &cache_month, &cache_day);
  cache_sod = local % SECS_PER_DAY;
}

void Timebase_SetUnix(uint32_t unix_sec)
{
  unix_ref   = unix_sec;
  tick_ref   = HAL_GetTick();
  time_valid = 1U;
  Timebase_Save();
}

void Timebase_SetFallback(uint32_t unix_sec)
{
  unix_ref   = unix_sec;
  tick_ref   = HAL_GetTick();
  time_valid = 0U;
}

uint8_t Timebase_Restore(void)
{
  uint32_t unix_sec = HAL_RTCEx_BKUPRead(&hrtc, TIMEBASE_BKP_UNIX);

  if ((unix_sec < TIMEBASE_MIN_UNIX) || (unix_sec > TIMEBASE_MAX_UNIX))
    return 0U;

  unix_ref   = unix_sec;
  tick_ref   = HAL_RTCEx_BKUPRead(&hrtc, TIMEBASE_BKP_TICK);
  saved_unix = unix_sec;
  time_valid = 1U;

  return 1U;
}

uint8_t Timebase_IsValid(void)
{
  return time_valid;
}

uint32_t Timebase_GetUnix(void)
{
  uint32_t elapsed_s = (HAL_GetTick() - tick_ref) / TICKS_PER_SEC;

  unix_ref += elapsed_s;
  tick_ref += elapsed_s * TICKS_PER_SEC;

  if (time_valid && ((unix_ref - saved_unix) >= TIMEBASE_SAVE_S))
    Timebase_Save();

  return unix_ref;
}

uint32_t Timebase_GetSecOfDay(void)
{
  Timebase_Refresh();
  return cache_sod;
}

uint8_t Timebase_GetDay(void)
{
  Timebase_Refresh();
  return cache_day;
}

uint8_t Timebase_GetMonth(void)
{
  Timebase_Refresh();
  return cache_month;
}

uint16_t Timebase_GetYear(void)
{
  Timebase_Refresh();
  return cache_year;
}

uint32_t Timebase_GetDateKey(void)
{
  Timebase_Refresh();

  return (uint32_t)cache_year * 372UL
       + (uint32_t)cache_month * 31UL
       + (uint32_t)cache_day;
}

int16_t Timebase_GetTimezoneMin(void)
{
  Timebase_Refresh();
  return cache_tz_min;
}

uint32_t Timebase_LocalToUnix(uint16_t year, uint8_t month, uint8_t day,
                              uint8_t hour, uint8_t min, uint8_t sec)
{
  uint32_t guess = Timebase_ToUnix(year, month, day, hour, min, sec, TIMEBASE_TZ_WINTER);

  return Timebase_ToUnix(year, month, day, hour, min, sec, Timebase_ZoneAt(guess));
}
