Hosty-04/ChickenCoop/Master/Core/Inc/battery.h

/**
  ******************************************************************************
  * @file    battery.h
  * @brief   Battery and panel monitoring (INA226 + divider) – MOSFET separator
  ******************************************************************************
  */

#ifndef BATTERY_H
#define BATTERY_H

#include "main.h"

void    Battery_Init(void);
void    Battery_Measure(void);
void    Battery_Process(void);
uint8_t Battery_WorkPending(void);
void    Battery_Request(uint8_t full);
void    Battery_Reschedule(void);

uint8_t  Battery_IsCritical(void);
uint16_t Battery_GetVoltage_mV(void);
uint16_t Battery_GetPanelVoltage_mV(void);
uint8_t  Battery_IsVoltageValid(void);
uint8_t  Battery_IsPanelValid(void);

#endif /* BATTERY_H */
