Hosty-04/ChickenCoop/Master/Core/Inc/telemetry.h

/**
  ******************************************************************************
  * @file    telemetry.h
  * @brief   LoRa uplink and downlink handler
  ******************************************************************************
  */

#ifndef TELEMETRY_H
#define TELEMETRY_H

#include "main.h"
#include "nests.h"

#define TELEMETRY_EGGS_MAX       10U

#define TELEMETRY_LEN_STATUS     2U
#define TELEMETRY_LEN_FULL       (2U + ((NESTS_COUNT + 1U) / 2U))
#define TELEMETRY_LEN_DOWNLINK   1U
#define TELEMETRY_LEN_DL_MAX     (1U + ((NESTS_COUNT + 3U) / 4U))

void    Telemetry_RequestStatus(void);
void    Telemetry_RequestFull(void);
uint8_t Telemetry_Pending(void);
void    Telemetry_Requeue(uint8_t length);
void    Telemetry_Clear(void);

uint8_t Telemetry_Build(uint8_t *buf, uint8_t buf_size);
void    Telemetry_HandleDownlink(const uint8_t *buf, uint8_t length);

#endif /* TELEMETRY_H */
