Hosty-04/ChickenCoop/(commit log)

2026-06-28 Create schematics
2026-09-04 Added Master
    [panel_characteristic.xlsx]
2026-09-06 Added limit switches to Master
2026-09-07 Modified schematics & flowcharts
2026-09-14 Modified Flowcharts
2026-09-16 Added battery datasheet
2026-09-17 Fix stale deferred door request and ADC channel selection
    door.c: Door_Process() cleared door_deferred_evt but not door_deferred_req
    when a new manual request was executed. A manual command that had been
    postponed because of radio activity therefore survived and was replayed
    about ten seconds after the newer, superseding command had already moved
    the door.
    adc_if.c: MX_ADC_Init() puts ADC_CHANNEL_2, VREFINT and TEMPSENSOR into
    the ADC's fixed (not fully configurable) sequencer. ADC_ReadChannels()
    only added the requested channel on top of that, so the conversion that
    was polled and read back was always the lowest channel number in the
    sequence (ADC_CHANNEL_2, the panel divider). SYS_GetBatt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
    [door.c]
2026-09-17 Address review items 1, 3, 5, 6, 9, 10, 12, 13
    lora_app.c: a telemetry request raised inside smtc_modem_run_engine()
    (downlink handler, JOINED event) used to wait for the next modem wake-up,
    because the low-power guard only looked at System_WorkPending(). It now
    also checks LoRaWAN_UplinkWaiting(), so the loop runs one more pass and
    LoRaWAN_SendPending() gets to send. The check deliberately ignores
    telemetry that is still in the 30 s TX backoff, otherwise the MCU would
    spin instead of sleeping until the retry is due.
    door.c: Door_ClearFault() now calls Door_Catchup(), so the door is brought
    to its scheduled position right after being unblocked instead of waiting
    for the next hourly resync.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
2026-09-17 Hysteresis, hang hardening, and move civil-time code into timebase
    battery.c: the critical threshold gets a two-sided 50 mV hysteresis, so it
    trips at limit - 50 mV and releases at limit + 50 mV instead of chattering
    around a single point. Winter now trips at 6.10 V and releases at 6.20 V,
    summer 5.95 V / 6.05 V. The over-voltage threshold is left as it was; its
    hysteresis already applies only to reconnecting the panel.
    door.c: Door_StoreState() no longer writes the endstop position into the
    backup register. Door_LoadState() always re-measures the position, so the
    stored byte was never read back and only made the stored word look like it
    carried more state than it did.
    stm32wlxx_it.c: the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
    [astro.c, astro.h, battery.c, door.c, lora_app.c, motor.c, power.c]
2026-09-17 Defer the battery check for the radio, drop hysteresis, flag dead sensors
    battery.c: Battery_Process() now asks LoRaWAN_CanBlockFor() before it
    switches to LP Run. Switching suspends the radio, and the suspend path in
    the modem calls lorawan_api_core_abort(), which kills a transmission in
    flight, closes an open RX window and discards an already received downlink.
    The measurement is postponed by 10 s when the modem is busy, the same way
    a door movement already was. The budget is 400 ms against roughly 250 ms of
    real blocking time. After six postponements the measurement runs anyway, so
    battery protection cannot be starved by radio traffic.
    battery.c: both thresholds lose their hysteresis. Th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
2026-09-17 Keep the ADC internal paths alive and always re-arm the door timer
    adc.c: the sequencer left behind by MX_ADC_Init() is now cleared with
    LL_ADC_REG_SetSequencerChRem() instead of three HAL_ADC_ConfigChannel()
    calls with ADC_RANK_NONE. The HAL call also switches off the VREFINT and
    temperature-sensor buffers, so ADC_ReadChannels() had to re-enable VREFINT
    immediately before starting a conversion, leaving under 10 us of the 12 us
    the reference needs to settle. Clearing only the sequencer keeps the buffers
    powered from MX_ADC_Init() until HAL_ADC_DeInit(), which turns them off
    anyway, so nothing stays enabled over Stop2.
    door.c: Door_Process() re-arms the timer on every event it handles while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
2026-09-17 Stop automatic door movement while the INA226 is not answering
    The INA226 is what measures motor current, so it is also the obstacle
    detection. Door_AutoAllowed() now additionally requires the last battery
    measurement to have succeeded, so sunrise and sunset movements and
    catch-ups are held off while the sensor is silent instead of running on a
    frozen battery_critical value.
    Battery_UpdateSensor() mirrors Battery_UpdateCritical(): it only acts on a
    change, reschedules the door either way and runs a catch-up when the sensor
    comes back, so the door corrects its position immediately rather than
    waiting for the next hourly resync.
    A consequence of the same gate is that the door no longer moves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
    [battery.c, door.c]
2026-09-17 Treat an implausible battery reading as a dead sensor
    A successful I2C transfer does not mean the INA226 returned a usable value.
    A bus voltage register stuck high reads as about 82 V, which passed the
    HAL_OK check, kept battery_mv_valid set and let the door keep moving while
    the over-voltage branch held the panel disconnected for good; the uplink
    reported the capped code 60, which looks like a full battery. A register
    stuck at zero was caught only indirectly, by the critical threshold, and
    was reported as a flat battery rather than a sensor failure.
    The reading now also has to fall between 1 V and 12 V. Below 1 V the LDO
    could not be running the MCU, and above 12 V is beyond the panel's 11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
    [battery.c]
2026-09-17 Reserve the LoRaWAN context pages in the linker script
    The ROM region covered the whole 256 KB of flash, including the two pages
    at 0x0803F000 that lora_app.c hands to FLASH_IF as LORAWAN_NVM_BASE_ADDRESS
    for the secure element, modem and stack contexts. Nothing stopped the
    linker from placing code there. A firmware that grew past 252 KB would link
    without a word and then erase part of itself the first time the modem saved
    its context, because FLASH_IF_Write() erases the whole 2 KB page around the
    data it is asked to write.
    ROM is now 252 KB and the reserved area is a separate NVM region, so a build
    that would collide fails at link time. The current image ends at 0x080360E0,
    about 36 KB bel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
2026-09-17 Only tear down the trace UART when traces are actually off
    main() called vcom_DeInit() unconditionally, which resets USART2, disables
    its clock and de-initialises the TX DMA channel. The advanced trace layer
    was left running. Its send path disables Stop mode through
    UTIL_ADV_TRACE_PreSendHook() and only re-enables it from
    UTIL_ADV_TRACE_PostSendHook(), which runs off the transfer-complete
    callback. With the UART torn down that callback can never fire, so the
    first trace to be emitted would have left CFG_LPM_UART_TX_Id in
    StopModeDisable permanently and UTIL_LPM_EnterLowPower() would have used
    Sleep instead of Stop2 for the rest of the run.
    Nothing emits a trace in the shipped configuration: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
    [main.c]
2026-09-17 Give the INA226 conversion waits a real margin
    BATTERY_CONV_MS and MOTOR_SAMPLE_MS were set just above the INA226's
    typical conversion time (70.4 ms at AVG=64 and 35.2 ms at AVG=16), so a
    few percent of internal-oscillator drift was enough to make a read land
    before the conversion finished and return the previous result. Raise
    them to 80 ms and 40 ms.
    PANEL_SETTLE_MS was 125 ms against a divider time constant of 24.6 ms,
    which is barely five time constants. Raise it to 200 ms so the reading
    no longer depends on the exact resistor and capacitor values.
    BATTERY_BLOCK_MS follows, because the budget handed to
    LoRaWAN_CanBlockFor() has to cover the longer waits.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
    [battery.c, motor.c]
2026-09-18 Stop chasing a refused uplink after three attempts
    LORAWAN_TX_RETRY_MAX counts retries on top of the initial attempt, so a
    value of 3 meant four transmit attempts spread over 90 seconds. Drop it
    to 2 for three attempts over 60 seconds.
    A refused uplink is smtc_modem_request_uplink() declining to queue the
    payload, which clears in seconds once the modem finishes whatever it was
    doing. Duty cycle is not a plausible cause here: 146 uplinks a day come
    to about 27 s of airtime against the 864 s the 1 % limit allows. If two
    thirty-second waits have not cleared it, a third will not either, and
    Battery_Process() queues a fresh status within ten minutes regardless.
    The shorter window also keeps the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
    [lora_app.c]
2026-09-18 Ask for the time three times quickly before falling back to hourly
    Until a time arrives the door cannot move at all, and the only thing that
    asks for one is Door_MaintainTimeSync() on the hourly resync. A lost
    DeviceTimeAns therefore froze the door for up to an hour even with a
    healthy link.
    Offer a 30 s candidate in Door_Schedule() while the time is invalid, and
    spend a budget of three of them. The candidate reuses DOOR_EVT_RESYNC, so
    the handler is unchanged. After a cold start the requests land at 5 s,
    35 s and 65 s, then the schedule returns to the hourly tick.
    The budget is spent in Door_Process() ahead of the door_enabled check, so
    a disabled system cannot sit in a 30 s wake loop, an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
2026-09-18 Only spend a fast time-sync attempt once the modem can actually send
    The first fast attempt landed 5 s after boot, and the join cannot possibly
    be finished by then: the fastest path is a 0 s random join delay plus
    62 ms of JoinReq airtime at SF7 plus the 5 s JOIN_ACCEPT_DELAY1. So
    LoRaWAN_RequestTime() always no-opped on its join check and one of the
    three attempts was guaranteed to be wasted. A join that took longer than
    65 s wasted all three.
    Gate both the candidate and the budget on LoRaWAN_IsJoined(), and
    reschedule from the JOINED handler so the fast phase starts at the moment
    the modem becomes usable rather than at a fixed offset from boot. The
    attempts now follow the join wherever it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
    [door.c, lora_app.c]
2026-09-18 Count the request sent on JOINED as the first fast time-sync attempt
    The JOINED handler already fires a DeviceTimeReq the moment the modem
    becomes usable, so a budget of three added two more on top of it and the
    fast phase sent four requests in total. Drop the budget to two for three
    requests: one at the join, then 30 s and 60 s after it.
    Claude-Session: https://claude.ai/code/session_012uJPopAbTycWF1iuAHRCqG
2026-09-18 Do not act on a downlink the modem did not hand over
    smtc_modem_get_downlink_data() returns SMTC_MODEM_RC_FAIL when its FIFO is
    empty and leaves *length and *metadata untouched. rx_payload,
    rx_payload_size and rx_metadata are static, so on that path the DOWNDATA
    handler re-read the previous downlink and executed it again. A repeated or
    spurious event could therefore replay the last command and move the door
    on its own.
    ASSERT_SMTC_MODEM_RC() swallows the return code, so clear rx_payload_size
    before the call and require it to be non-zero afterwards. A failed fetch
    now leaves it at zero and the handler does nothing. Valid traffic is
    unaffected: Telemetry_HandleDownlink() only accepts a one by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
    [lora_app.c]
2026-09-18 Make the startup timeouts expire, recover a dead session, bound a restored time
    Three separate holes, all of which left the device stuck with no way out.
    HAL_GetTick() returned a constant zero until UTIL_TIMER_Init() had run, so
    every HAL timeout taken before that point compared zero against zero and
    never expired. A dead LSE hung SystemClock_Config() forever at MSI 4 MHz,
    and ST's own comment in HAL_GetTick() warns that MX_RTC_Init() has the same
    problem. Give the early path the free running counter ST left the USER CODE
    block for. It advances once per 1024 calls, which turns the 5000 ms LSE and
    clock switch timeouts into roughly 38 s of real time in a Release build and
    the 1000 ms RTC ini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
    [door.c, timebase.c, timebase.h]
2026-09-18 Treat an implausible panel reading as a dead sensor too
    The battery reading goes through Battery_Plausible() before it is trusted,
    but the panel reading was trusted whenever the ADC returned HAL_OK. The two
    paths are not symmetric, and the panel one feeds a decision that matters:
    Battery_ReadPanel() derives VDDA from VREFINT, so a broken VREFINT makes
    __LL_ADC_CALC_VREFANALOG_VOLTAGE() return a huge supply voltage and v_panel
    scales with it. Telemetry survives that because the code saturates at
    PANEL_CODE_MAX, but Battery_UpdateBackfeed() would then see v_panel above
    v_bat and leave the panel connected all night, which is the one thing that
    check exists to prevent.
    Add Battery_PanelPlausibl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
    [battery.c]
2026-09-18 Derive I2C SCLDEL from the required data setup time
    The hardcoded SCLDEL=4 was sized for the 1 MHz clock. At 48 MHz it
    yields 5 x 20.83 ns = 208 ns of data setup, 17 % below the 250 ns
    standard-mode t_SU;DAT minimum, with no allowance for SDA rise time.
    Compute it from a 450 ns target instead, and keep SCLL >= SCLDEL so
    the setup delay always fits inside the SCL low period.
    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
2026-09-25 Stop the DMA clocks when the trace is switched off
    MX_DMA_Init() enables DMA1 and DMAMUX1, but the only DMA client in the
    project is the USART2 TX path of the debug trace. With VERBOSE_LEVEL at
    VLEVEL_OFF the trace is torn down in main(), and both clocks were left
    running for nothing. Disable them in vcom_DeInit(), after MspDeInit has
    reset the channel.
    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
2026-09-25 Skip the trace resume when the trace is switched off
    PWR_ExitStopMode() calls vcom_Resume() on every Stop2 exit, and that
    re-inits a USART2 and a DMA channel that main() already tore down when
    VERBOSE_LEVEL is VLEVEL_OFF. Return early under the same condition that
    governs the teardown. sys_conf.h has to be included for VERBOSE_LEVEL to
    be visible here; without it the test would silently compare two
    undefined macros.
    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
2026-09-26 Reject a panel reading that is pegged at full scale
    PANEL_MAX_VALID_V was 13.5 V, above the 13.0 V the divider can reach at
    VDDA 3.3 V, so the upper bound never rejected anything: a shorted input
    read as a healthy 13 V panel. The panel's Voc is 11 V, so lower the bound
    to 12.5 V, and treat a raw ADC value of 4095 as a failed read, since that
    only means the input sits at or above full scale. The raw test does not
    move with VDDA, which a fixed voltage bound does.
    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
    [battery.c]
2026-09-26 Raise the panel telemetry ceiling to what the input range allows
    PANEL_CODE_MAX 110 clipped the reported panel voltage at 11.0 V, which
    threw away everything the divider gained when R2 went to 330 kOhm. The
    plausibility bound rejects anything above 12.5 V before it reaches the
    encoder, so 125 is the highest code a real reading can produce at the
    100 mV step. The field itself would allow 126, but that code would never
    be emitted.
    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
2026-09-26 Disconnect the panel while the battery reading is unusable
    Battery_Process() restored the panel to whatever state it had been in
    whenever the battery reading could not be used, so a dead INA226 left
    the panel charging with nothing watching the cell voltage. The panel can
    push 1.2 A into a battery whose limits are 7.2 to 7.5 V, and the cost of
    being wrong the other way is a slow discharge against a reserve measured
    in hundreds of days, reported in telemetry from the first cycle.
    Disconnect instead, and recover on the next reading that works.
    Also restore BATTERY_PANEL_HYST_V in Battery_UpdateBackfeed(), removed in
    7afd279, at its original 50 mV. Comparing panel against battery with no
    margin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
    [battery.c]
2026-09-28 Add the MQTT bridge, storage and dashboard
    Second half of the chain the README describes: TTN forwards uplinks over
    MQTT to this server, which decodes them, stores them in InfluxDB and
    serves a dashboard; downlinks travel the same path backwards.
    src/codec.js holds the payload rules and is the one place that has to
    stay in step with telemetry.c. It refuses command pairs the firmware
    ignores rather than sending a byte that does nothing. test/ checks it
    against payloads captured from the device itself.
    Runs with docker compose up; InfluxDB initialises itself from .env, and
    the app waits for its healthcheck. Node is only needed for the dev
    workflow and the tests.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
2026-09-28 Drop the tests and write the README for whoever installs this
    The README was written for someone who already had a working TTN
    account, a claimed gateway and a registered device. Whoever ends up
    installing this has none of those, so it now walks the whole path:
    account, gateway over Wi-Fi, application, device, payload formatter,
    then the server. The three device credentials are called out as
    something that arrives with the coop, since they cannot be invented.
    Removed test/ and the test script.
    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
2026-09-28 Put the dashboard behind a login and make it installable
    The dashboard had door controls and no authentication, so anyone who
    reached it could open the coop. It now sits behind a session cookie:
    a random 32-byte token, httpOnly, checked on every request and on the
    WebSocket upgrade. Five wrong attempts lock an address out for fifteen
    minutes, and credentials are compared as SHA-256 digests so the check
    takes the same time whether the name is right or not.
    The password lives in .env beside the TTN key and the database token,
    which already grant the same power, so it is not hashed there. The README
    says so and tells the reader not to reuse it.
    Icons and a manifest turn the page into somethin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
2026-09-28 Let the queued downlink be cancelled
    Track every downlink pushed to TTN in a session-local queue, drop an entry
    once TTN reports it sent or acknowledged, and expose the queue through
    /api/status and a live websocket broadcast.
    Cancelling publishes an empty downlink list to down/replace, which clears
    whatever the network actually holds. The button stays enabled even when the
    local queue looks empty, so a queue left over from before a server restart
    can still be cleared.
    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
2026-09-28 Store readings in SQLite instead of InfluxDB
    InfluxDB was the reason the server needed a 64-bit system and 2 GB of memory:
    its image is published for amd64 and arm64 only, and it wants far more room
    than the dashboard itself, which measures 87 MB resident. Nothing about one
    reading every ten minutes justifies that — a year of them is about 4 MB.
    Storage moves to SQLite through node:sqlite, so there is no second container,
    no native module to compile on the Pi, and no dependency at all: the module
    ships with Node. The bucket sizes of the old Flux query carry over as integer
    division on the millisecond timestamp, and the window is stamped at its end
    as aggregateWindow did, clamped so the la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
2026-09-28 Add a year-long range and soften the dashboard's messages
    The chart stopped at 30 days, which is a season, not a year: with one reading
    every ten minutes a year is 52 560 rows, so the range clamp rises to 8 760
    hours and days become the bucket beyond a month — 365 points, the same order
    as the other views. Labels follow the range now, since a date without a year
    means nothing across twelve months and a clock time means nothing on a daily
    average.
    Success messages disappear after five seconds. Errors stay, because a message
    that says something went wrong is worth reading after looking away.
    Cancelling an empty queue said "Fronta vyprázdněna", which claims an action
    that did not happen;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
2026-09-28 Shorten the cancel button to one word
    It sits inside the row labelled "Ve frontě", so repeating "frontu" on the
    button said the same thing twice. The README follows the label.
    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
2026-09-28 Say exactly what the stored readings survive
    "Data přežijí i smazání a znovuvytvoření kontejnerů" is true but leaves the
    reader guessing where the line is. The readings live in a named volume on
    the card, so the line is now drawn: restarts, power cuts, `down` and up
    again, updates and rebuilds, a pruned image — against the two commands that
    delete the volume, named so they can be avoided.
    Also notes that a power cut can cost the last reading or two that had not
    reached the card, which the database survives intact.
    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
2026-09-28 Say it in Czech everywhere the page can show it
    "Příkaz selhal: not connected to TTN" was the page relaying an English
    message straight from the server. Every error that can reach a visitor is
    now Czech: the two that fire when the MQTT link is down, and the three the
    command encoder raises. Log lines stay English, and the README quotes them
    that way.
    Where the text came from the browser rather than from us — a failed fetch
    reads "Failed to fetch" — the toast now says the server is not answering
    instead of passing the English through. The database error no longer shows
    its raw message either; that belongs in the log, and what the visitor needs
    to know is that readings may not be stored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
2026-09-28 Stop a hung request from disabling a button forever
    A command button greys itself out while the request is in flight and comes
    back when it settles. Over a network that swallows packets rather than
    refusing them, a fetch settles at the browser's own leisure — minutes, or
    never on a half-open connection — and the button stays grey with nothing
    said. Exactly what a phone on a hotspot does to a page served over it.
    Every request the page makes now gives up after eight seconds, which puts
    it back on the regular path: the button returns, and the toast says the
    server is not answering. The login form had the same hole and could sit on
    "Přihlašuji…" indefinitely; it now recovers with the s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
2026-09-28 Subscribe to this device, not to every device in the application
    The MQTT subscriptions used a wildcard where the device id belongs, so the
    bridge received traffic for anything registered under the same application.
    An uplink from another device would be stored under its own id and never
    shown, and worse, its downlink event would retire an entry from this
    device's queue, because an event that matches no correlation id falls back
    to the oldest one. Both topics now name the device the server is configured
    for.
    A `.dockerignore` keeps `node_modules`, the database and `.env` out of the
    build context. On a Pi that context is copied for every build, and none of
    it is used: the image installs its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
2026-09-28 Lay the top bar out for a phone
    The bar kept the title and the three controls as two groups pushed apart.
    On a phone they no longer fit side by side, so the controls dropped to their
    own line and sat against the left edge, leaving as much as 72px of empty
    space on the right — the layout looked like it had given up rather than
    adapted.
    The badge is now a sibling of the title rather than part of the button
    group, so a narrow screen wraps it where it belongs: title and connection
    state on one line, the two buttons right-aligned underneath. The badge no
    longer shrinks or wraps its own text, which it did below 360px.
    The range buttons lost a little padding on phones, enough for all five to
    sh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
2026-09-28 Stop calling the local network permission a Chrome thing
    It is not. Firefox for Android asks the same question — per site, from
    version 149 for strict tracking protection, rolling out to everyone from
    151 — and Android 16 adds a permission of its own that applies to whichever
    browser is installed.
    The line also tied the permission to resolving `.local`, which reads as if
    typing the address instead made it irrelevant. It is its own thing: a
    browser asking whether a page may reach into the home network. This page
    reaches nothing but the Pi it is served from, so the answer is yes.
    Claude-Session: https://claude.ai/code/session_012uJPop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
2026-09-28 Walk through the DHCP reservation instead of naming it
    "Najděte DHCP reservation, bývá pod Wi-Fi, LAN nebo DHCP" tells someone who
    already knows how where to look. The step now walks through it: finding the
    router's own address, what the setting is called in each of the four ways
    routers name it, picking the Pi from the client list or entering its MAC,
    and rebooting so the Pi takes the address. The MAC line named `wlan0` only,
    which is the wrong interface for a Pi on a cable.
    The DNS paragraph said a router could hold a name for the Pi without saying
    what that buys or where to find it. It now says where the setting usually
    sits, that `http://kurnik:3000` then works on every device in the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
2026-09-28 Give the reader a way out when the router will not let them in
    Boxes from an internet provider often keep the administrator account for
    themselves, and the reservation step ends there with nothing to try. The
    address can be fixed on the Pi instead, which the step now shows, along
    with reading the connection name rather than assuming it.
    It also warns to stay outside the range the router hands out: an address
    from inside it can be leased to something else later, and then two devices
    fight over it — the failure the reservation was meant to prevent, arriving
    by another door.
    Claude-Session: https://claude.ai/code/session_012uJPopAbTycWF1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
2026-09-28 Say the address once, where both phones and computers can find it
    Chapter 7 told a reader with a computer to look for the IP address "o kousek
    níž u Androidu", and what they found there was a numbered list whose second
    item ran for thirty lines of router menus. The address is the same for every
    device, so it now has its own part at the top of the chapter — the two ways
    to write it, then pinning it — and each device section is what is actually
    different about that device: three short steps for Android, two lines for a
    computer.
    The router's own name-for-an-address trick moved up with it. It belongs
    beside the reservation it sits next to in the router, not stranded after the
    Android not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
2026-09-30 AppKey filter
2026-09-30 Make the fallback address readable without knowing the answer first
    The passage contradicted itself. It opened with "you cannot get into the
    router" and then sent the reader into the router's settings to read the
    DHCP range — the one place the premise says is closed. It now names a safe
    number instead and gives a way to test it from outside: turn the Pi off and
    ping the address from another machine.
    The rest assumed the reader could see which parts of the command were theirs
    to change. Four values, no indication that three are placeholders. The step
    now collects those three first, each with the command that prints it, then
    says which is which in the line below. `/24` is explained as the p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
2026-09-30 Added github flowcharts
2026-09-30 Added github schematics & plot
2026-09-30 Deleted github schematics, flowcharts & plot
2026-10-01 Modified block schematic
2026-10-01 Add a range that covers everything stored
    A year was the longest view, so a coop in its third winter could not be
    compared against its first. "Vše" starts at the oldest reading and lets the
    span pick the bucket, which keeps the point count in the same order as every
    other view rather than growing without limit: a week per point beyond a year,
    so two years is about a hundred points and five years is still under three.
    Measured against 400 days of readings: 58 points at seven-day spacing, and
    the shorter ranges unchanged — 35 for a month, 363 for a year.
    A sixth button no longer fits one phone line. Rather than letting "Vše" drop
    alone onto a second row, the range buttons become three co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
2026-10-01 Let the stored history be deleted, behind the password
    There was no way to throw away readings — a test run, a wrong clock, a coop
    moved to another garden. The Data card shows how many are stored and offers
    to delete them; the dialog asks for the login password first, because being
    signed in on a phone someone left unlocked should not be enough to wipe
    years of measurements.
    **Testing caught a bug worth naming**: a wrong password first answered 401,
    which the page treats as an expired session, so it redirected to the login
    screen. Mistyping the confirmation logged you out. It answers 403 now —
    authenticated, refused — and the dialog shows the error and stays open.
    After a wipe the ti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
2026-10-01 Average the panel over daylight readings only
    A bucket that mixes day and night halved the panel voltage: the yearly
    view, where one point is a whole day, showed around 3.5 V for a panel
    that never read less than 6.7 V in daylight. The average now skips the
    zeros, and a bucket that holds nothing but night still reports zero, so
    short ranges keep showing the nights.
    The chart says so under the plot on every averaged range, the README
    explains it, and the wipe dialog now asks for a backup instead of
    pointing at one.
    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
2026-10-01 Keep the wipe dialog closed until it is asked for
    Styling `dialog` rather than `dialog[open]` beat the browser's own
    `dialog:not([open]) { display: none }` — author rules win over the user
    agent sheet whatever their specificity — so the confirmation sat open
    at the bottom of every page load, below the Data card, asking whether
    to delete the history nobody had offered to delete.
    Scoping the rule to the open state hands the closed case back to the
    browser. Checked on load, after the button, and after cancelling:
    display none, then grid as a real modal with its backdrop, then none
    again.
    Claude-Session: https://claude.ai/code/session_0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
2026-10-01 Shorten the delete button to Smazat
    The card it sits on is already titled Data and the row beside it reads
    Uloženou měření, so the button repeated what its surroundings said.
    The dialog it opens still names what is being deleted.
    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
2026-10-01 Report the wipe where the data is, and group the digits
    Three things the two-year database made visible.
    Six digits ran together as "103846 záznamů". Czech groups them with a
    non-breaking space, so the count now reads 103 846 and never breaks
    across a line. The same helper counts queued commands, which never
    reach four digits, so nothing else moves.
    The result of deleting was announced in the Ovládání card, under the
    line about commands waiting in the queue — the wrong card entirely.
    The Data card has its own line now, and each line keeps its own
    five-second timer so one does not cut the other short.
    Deleting nothing reported success: "Historie smazána: 0 záznamů". The
    button is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
2026-10-01 Warn that a leftover WAL ruins a restore
    The restore steps said to stop the server and copy the file back, which
    is enough while the stop is clean: the server closes the database on
    SIGTERM and the -wal and -shm files are written back and removed. After
    a power cut or a hard shutdown they survive, and SQLite then replays
    that old WAL onto whatever database it finds beside it.
    Measured on a copy: a 103 846-row file opened as 2 577 rows mixing two
    devices, with integrity_check reporting rows out of primary key order.
    The chapter now says to list the volume first and remove the leftovers
    before copying, and that cp writes the whole file under the name in the
    destination path.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
2026-10-01 Leave the chart hidden while the table is up
    Changing the range redrew the chart, and the redraw decided on its own
    whether the plot should be visible — it knew about having no data, but
    not about the table being up. So picking 24 h while reading the table
    put the chart back above it and both were on screen at once.
    The redraw now asks what the table is doing, the same way the toggle
    button already does. Chart.js refits the canvas when the wrapper comes
    back, so switching to the graph after several range changes still draws
    at full width: measured 1010x320 both before and after.
    The last-message tile separated the age from the signal with a middle
    dot, which sat badly against the minus s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
2026-10-01 Take the legend down with the chart
    The colour key belongs to the plot. Above the table it labelled nothing
    — there are no colours in the columns — and above the empty state it
    offered a key to a chart that was not there.
    It needed a CSS rule as well as the attribute: `.legend` sets
    `display: flex`, which beats the browser's `[hidden] { display: none }`,
    so setting the attribute alone would have changed nothing. The same
    trap that kept the wipe dialog on screen; the other hidden elements on
    the page set no display of their own and are unaffected.
    Also rewrote the README line about listing the volume. "Při prvním
    spuštění se stáhne malý pomocný obraz" read as if the server were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
2026-10-01 Name each point by the period it covers, not the one after
    Every bucket was labelled with its own end: the day starting 30 Sept
    was called 1 Oct, the day before it 30 Sept, and so on down the table.
    The newest bucket is still filling, so its end was clamped to the
    current time — which fell on the same date as the previous bucket's
    end, and the year view showed 1 Oct twice, two different days under
    one date.
    Labelling by the start says what each row holds and cannot collide,
    since bucket starts are multiples of the bucket. Checked against the
    same averages read straight out of SQL: 1 Oct 7.14 V, 30 Sept 7.19 V,
    29 Sept 7.19 V, 28 Sept 7.18 V, 27 Sept 7.14 V, matching row for row,
    and 365 d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
2026-10-01 Keep the first date out of the voltage scale
    The leftmost date was centred on a point sitting at the very edge of
    the plot, so half of it hung past the axis and landed beside the bottom
    voltage label: "2 V" and "2. 10. 2025" crowded into the corner.
    Aligning the end labels inward fixes the corner but breaks the narrow
    widths on its own: Chart.js picks visible labels by skipping whole
    steps, and the last one it keeps often falls well short of the right
    edge, where inward alignment then drags it into its neighbour — three
    dates became two overlapping ones at phone width.
    So the labels are no longer chosen by skipping. The number that fits
    comes from the plot width and how wide the labels a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
2026-10-01 Cut the buckets by local time, and mark the ticks
    The 30-day axis read 20:00 on every label because the buckets were cut
    on UTC boundaries: six-hour steps from midnight UTC land at 02, 08, 14
    and 20 in Czech summer time, and a label at noon was therefore not
    reachable. The grouping now runs on local time, so the steps fall on
    00, 06, 12 and 18, a day starts at local midnight rather than 02:00,
    and the daily averages cover the day they are named after. The image
    gets tzdata and compose a TZ, defaulting to Europe/Prague.
    Which points get labelled is no longer purely even spacing: where the
    labels are a day or more apart they snap to the nearest noon, and where
    they are hours apart to the whol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
2026-10-01 Space the labels by a whole number of days
    Thirty days over seven gaps is 4.3 days, and rounding each label
    separately to the nearest noon made that 5, 4, 4, 4, 5, 4, 4 — two gaps
    a quarter wider than the rest, which shows.
    The step itself is now a whole number of units, rounded up so it never
    asks for more labels than fit: five days on the month, one on the week,
    four hours on the day. The month reads 1., 6., 11., 16., 21., 26., 1.,
    six gaps of exactly five days, 164px each. One label fewer, an even
    rhythm.
    Ranges whose buckets are already a day or more keep spacing by index;
    there is nothing to snap to.
    Still 54 of 54 across nine widths and six ranges with no label
    overlapping another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
2026-10-01 Put the chart on a real time axis
    Every point had the same width whatever the gap before it, because the
    x scale was categorical — one slot per reading. Where measurements are
    missing, time was compressed: the first gap of the month view measured
    156px for the same five days the others drew at 164.
    The scale is linear over the timestamps now, so a pixel is a fixed
    amount of time and an outage leaves the hole it really is. The labels
    are no longer tied to data points either: the ticks are built straight
    from the chosen instants, which drops the trick of hiding the labels
    and grid lines of every point that was not chosen.
    Falling out of that: dates need a little more room, 115px rather tha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
2026-10-01 Keep the axis, the redraw and the count honest
    Three things found while going over the page at every width and on a
    phone in both orientations.
    **Labels survived a rotation they no longer fitted.** How many labels
    fit was worked out once, when the data arrived, and kept. Turning the
    phone resized the canvas without recomputing it, so six labels chosen
    for 774px of landscape stayed on 320px of portrait and ran into each
    other five times over. The choice now happens while the axis is built,
    which the chart redoes on every resize: six labels in landscape, two in
    portrait, and back.
    **Switching the range animated between two unrelated shapes.** Going
    from a month to a year interpolated 120 poi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
2026-10-01 Call a battery reading above 10 V a fault
    The plausibility window ended at 12 V, which no pack in this coop can
    reach: the telemetry runs out of codes at 8 V and anything past that is
    already reported as the top of the range. A reading between 10 and 12 V
    was therefore accepted and charted as if it were real, while it can
    only come from a broken measurement.
    Above 10 V the reading is now treated like any other sensor failure —
    the battery goes out as no-data, the panel is cut from the pack and the
    page shows čidlo neodpovídá.
    Builds at the same 117192 B of ROM.
    Claude-Session: https://claude.ai/code/session_012uJPopAbTycWF1iuAHRCq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
    [battery.c]
2026-10-01 Let the range button decide the width of the axis
    The axis spanned the data, not the range: it started at the first
    reading returned and ended at the last. While readings keep arriving
    the two coincide, but the moment the coop goes quiet the axis shrinks
    with it. Against a database whose last reading was five and a half
    hours old, 6 h drew twenty minutes of axis, 24 h drew 18.3, a week drew
    162 hours — each one claiming to be something it was not.
    The axis now runs from now minus the range to now, and only Vše takes
    its start from the data, which is what Vše means. A coop that has not
    reported for an hour leaves an hour of empty axis, which is the point.
    The ticks follow the same windo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
2026-10-01 Tell every page what one of them just did
    Cancelling the queue or deleting the history was announced only to the
    phone that pressed the button. On a second page the queue row emptied,
    because the pending list is broadcast, but the message still read
    "Zařazeno do fronty" for an order that no longer existed; after a wipe
    the count fell to zero while the chart went on drawing a hundred
    thousand readings that were gone, until that page was reloaded or its
    range changed.
    Both now go out over the socket the way queued commands already did,
    and the page that pressed the button reads its own confirmation from
    the broadcast rather than from its reply — the same path for everyone.
    A wipe also relo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
2026-10-01 Break the line where the readings stop
    Nine days without a reading drew a straight line between the last
    reading before and the first after, which reads as a steady voltage
    rather than as nothing at all. The line now ends where the readings
    end: a gap wider than two and a half steps gets an empty point, and
    gaps are no longer spanned, so a dropped reading shows as a short
    break and an outage as a hole the width of the outage.
    Short interruptions stay joined — a single missing bucket is two steps
    and falls under the threshold.
    The periodic status check no longer announces itself. It runs every
    minute, and while the server is unreachable each failure wrote "Server
    neodpovídá." over whate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
2026-10-01 Say it louder when a sensor goes quiet
    "Čidlo neodpovídá" looked like a side note: the same grey as "na horní
    mezi rozsahu", only a shade darker, and without the warning sign that
    the door's "koncový spínač nehlásí polohu" carries. Both now start with
    ⚠ and the whole is-warning class is orange — #b05600 on the light theme
    (4.9:1 against the tile) and #ec835a on the dark one (6.6:1), next to
    the unchanged red of a critical battery.
    The test databases are regenerated from Tests/seed.mjs, which is new.
    Two years of ten-minute readings ending two days in the future, so the
    dashboard keeps a full chart for a couple of days before the data goes
    stale; the chart clips at the present,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
2026-10-01 Measure the panel the way the coop does
    The panel in the test data crawled along two or three volts in daylight,
    which matches nothing the hardware can report. The firmware opens the
    separator and waits 200 ms before the ADC reads the panel, so what gets
    sent is the open-circuit voltage, and the panel is Voc = 11 V / Vmpp =
    9 V. The divider and PANEL_MAX_VALID_V = 12.5 V are sized for exactly
    that.
    The generator now models it: zero at night, a plateau near Voc through
    the day, falling with cloud cover (logarithmic, the way Voc does) and
    with the summer heat, rising in the winter cold. Daylight runs from 8
    to 16 hours over the year instead of 0 to 16 — the old curve had no
    daylight at all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
2026-10-01 One database per state the dashboard can show
    The two databases covered the charts and one combination of warnings.
    Six of them now cover the rest, each ending on the reading that puts the
    dashboard in that state: a critical battery with a dead panel sensor and
    an unknown door, a door fault with a dead battery sensor, both voltages
    at the top of the range, a last message five days old, a single reading,
    and nothing at all. They hold a week of data each, around a hundred
    kilobytes, so only the two-year one stays large.
    Tests/seed.mjs writes whichever are named, or all of them, and
    Tests/prikazy.txt says what each one shows.
    Measured: the critical battery reads 5.90 V in red, both dead senso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
2026-10-01 Explain the test data in a README
    Tests/prikazy.txt had the two commands and a one-line note per file.
    Tests/README.md replaces it with what the data need (a configured
    server, the device id the readings are stored under, Node 22 only for
    regenerating), how to put a database in place without losing the saved
    readings, what each of the seven shows, which events sit in which range
    of the chart and why each range needs a different length of outage.
    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
2026-10-01 Stop the dashboard at the present
    The window the dashboard asks for has a start and no end, so every
    reading stored ahead of now came back with it. The chart hid them
    because its axis stops at the present, but the table listed them all:
    426 rows in the 24 h range instead of 140, the first of them dated two
    days ahead and printed as a bare time, since the table only prints a
    date above 24 h.
    The history query and the query for the latest reading now stop at the
    present. Nothing changes for readings that arrive from the coop — their
    timestamp comes from the network server and is already in the past when
    the uplink reaches the Pi — and the test databases, which hold two days
    of readings ah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
2026-10-01 Sort the two fault databases by colour
    The battery swaps places: poplach now has both sensors silent beside
    the unknown door, so all three notes are the orange warning, and
    porucha has the critical battery beside the door fault, so both are
    red. Each database shows one kind of trouble instead of a mix.
    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
2026-10-01 Measure the point spacing against the window, not the count
    With the five-day-old database the seven-day chart drew its 48 points
    as a string of beads: the markers are hidden when they would crowd, but
    the test compared the plot width against the number of points, and
    those points sat in the first two days of the window, not across it.
    The spacing now comes from the window itself — the width of one bucket
    in pixels — so it holds wherever the readings stop. A chart with a
    single reading keeps its marker, since there is no spacing to measure.
    Markers are crosses instead of filled circles. A cross marks the
    reading without hiding the line under it, and where the line turns the
    cross stays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
2026-10-01 Put each message where its subject is, and let red ones stay
    "Historii se nepodařilo načíst" appeared under the buttons, three cards
    below the chart it was about, and the database error sat there too.
    The chart card has its own line now, the database error belongs to the
    Uložená měření card, and the line under the buttons is left to the
    buttons.
    Red messages no longer time out. A failed command or a database error
    is not something to catch within twelve seconds, so it stays until it
    is replaced or until what it reports is fixed: a history that loads
    clears the chart's message, a database that answers clears the data
    card's. The other messages still fade after five seconds.
    Measured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
2026-10-01 Say how to get your own measurements back
    The test data README said to copy a database over Server/data/kurnik.db
    and restart, which is the layout for running the server straight from
    node; on the Pi it lives in a Docker volume. Both ways now match
    Server/README.md: stop the server, keep a copy of what is stored, copy
    the test database in — and a section of its own for putting the backup
    back, including the -wal and -shm files that a power cut leaves behind
    and that SQLite would replay onto the restored database.
    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
2026-10-01 Start the weeks on Monday
    The slots are aligned to whole multiples of the step counted from the
    epoch, and 1 January 1970 was a Thursday, so the weekly averages of the
    Vše range ran Thursday to Thursday. Shifting the division by four days
    puts them on Monday. Four days is a whole number of ten-minute, hourly,
    six-hourly and daily steps, so the other ranges land exactly where they
    did.
    Measured on the two-year database: all 103 weekly slots now fall on a
    Monday at midnight, and the other ranges keep their boundaries — ten
    minutes in 24 h, whole hours in 7 days, 00/06/12/18 in 30 days and
    midnight in a year.
    Claude-Session: https://cla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
2026-10-01 Describe what a gap looks like, and stop the badge flashing on the way out
    The README told the reader what the page shows, not what it does when
    something is missing. A new section says it: an outage leaves a hole as
    wide as itself in the chart and drops the rows from the table, visible
    from about twenty minutes in the 24 h range up to two weeks in Vše; a
    reading that arrives without a value shows a dash and the orange sensor
    warning and breaks only its own line; a panel that is disconnected,
    shaded or broken reads 0.00 V rather than a dash, while a disconnected
    battery takes the whole coop with it and reads as an ordinary outage;
    and the note about the top of the range names the two voltag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
2026-10-01 Take the leaving mark back when the page comes back
    The flag that silences the badge while the page is leaving is set on
    pagehide, and pagehide also fires when a page is put into the back and
    forward cache — switching apps on a phone is enough. The page then
    comes back with the flag still set, so a server that stopped answering
    would never be reported, and the socket, closed while the page was
    away, would never be dialled again: the dashboard would sit there
    showing the last thing it saw.
    pageshow clears the flag, and a restored page reconnects and reloads
    its status and history. The socket is kept in one place now and
    connectSocket returns early if it is still connecting or open, so the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
2026-10-02 Talk to the nest units over Modbus
    A new module, coops, runs the hourly nest check. It switches on the
    RS485 branch (COM), wakes the LPUART, and walks the daisy chain: each
    nest unit gets a command, is polled until it reports done, and is then
    told to release the bus, which powers the next box. Unit n answers on
    Modbus address n. If one stays silent the boxes behind it never get
    power, so they are reported as not responding without waiting on them.
    The number of nests now lives in coops.h as COOPS_NEST_COUNT and the
    uplink length follows it.
    The register map the slaves will implement: the master writes command
    and argument into registers 0-1 (1 measure with today's date key for
    the once-a-d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
2026-10-02 Show the nests and what they laid
    The server decodes the nest nibbles of a full uplink and stores one row
    per nest in a new nests table, next to the reading and in the same
    transaction. NEST_COUNT, the same number as in the firmware, says how
    many there are.
    The dashboard gets a Hnízda card with one tray of ten places per nest
    that fills as eggs are counted, a note for a full basket, a broody hen,
    an uncalibrated or faulty scale and a nest that did not answer, and
    how many eggs each laid today. A broody or silent nest keeps showing
    its last known count. A Snáška chart below the voltages shows the eggs
    laid per hour, day or week for the selected range, with a per-nest
    breakdown in the too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
2026-10-02 Put the nests into the test data
    Every test database now has two nests checked on the full hour: hens lay
    mostly in the morning, more in summer, prefer the first nest, and the
    eggs are collected at five in the afternoon except on some days. Each
    range has its own nest event - a broody hen, nests that do not answer,
    three days without collecting, a faulty scale, an uncalibrated scale
    after installation - and the alarm databases end with silent nests,
    a faulty scale next to a broody hen, and two full baskets. While the
    battery is critically low no nest rows are written, as the coop skips
    the check.
    Claude-Session: https://claude.ai/code/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
2026-10-02 Call the nest module nests
    coops was meant to be nests. The files are now nests.c and nests.h, the
    functions Nests_*, the count NESTS_COUNT, the reference mass
    NESTS_CALIB_MASS_G and the states NESTS_STATE_*. Nothing else changes:
    the firmware builds to the same size, and the Server README and the
    NEST_COUNT error message point to the new names.
    Claude-Session: https://claude.ai/code/session_01Jfg68o2YkF9qP6hvnxQHXe
    [main.c, nests.c, nests.h, system.c, telemetry.c, telemetry.h]
2026-10-02 Start the nest check on the hour and let the battery check follow
    The nest check started two seconds before the full hour so that the
    battery check due at the hour would land inside it. Now it starts on
    the hour, and when it is done - or skipped because the system is off or
    the battery is critical - it asks the battery module for its check.
    The battery module leaves the full hour out of its own ten-minute
    schedule, so at the hour the order is fixed: nests first, then battery
    and panel, and both go out in one full uplink.
    On the host, every simulated check scheduled the next one exactly on
    the full hour and requested one battery check after it, the skipped
    one under a critical battery includ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
    [battery.c, battery.h, nests.c, nests.h]
2026-10-02 Let one downlink set the scale of several nests
    The second downlink byte carried one nest number and one operation, so
    two nests took two downlinks, one uplink apart. From the second byte on
    every nest now has a pair of bits, four nests to a byte with nest 1 in
    bits 0-1: 01 tares the scale, 10 calibrates it, and 00 or 11 leave it
    alone, the same rule as the pairs of the first byte. One downlink can
    tare some nests and calibrate others at once. A downlink longer than
    the nests need is ignored as a whole.
    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
2026-10-02 Tare and calibrate without measuring the nests
    A tare or calibration used to start a whole nest check right away,
    measuring every other nest out of turn as well. Now only the nests
    asked for get their command: the ones in front of them are just told
    to release the bus, so that power reaches the next box, and the ones
    behind them are not switched on at all. Their state is sent back in a
    full uplink, without a battery check. A request that cannot run - a
    critical battery, a nest that does not answer - stays until the next
    hourly check, which does it in place of the measurement.
    Whether a run is the hourly check is now decided by the time it is due,
    not by which timer fired. A calibration that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
2026-10-02 Pick several nests for one tare or calibration
    The scale controls had a single nest to choose. They now show one
    checkbox per nest, and Vynulovat and Kalibrovat act on every ticked one
    in a single downlink, built the way the firmware now reads it: a pair
    of bits per nest, four nests to a byte. The buttons stay disabled until
    a nest is ticked. The queue and the delivery messages name all the
    nests ("vynulovat váhu hnízd 1 a 2").
    The hint under the controls and the calibration steps in the README say
    that a tare or calibration happens as soon as the coop receives it and
    only in the ticked nests, that the coop reports the nests right after
    it, and that several commands in the queue still rea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
2026-10-02 Call the voltage card just Napětí
    Next to Hnízda and Snáška the card title reads better without "v čase".
    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
2026-10-02 Put the egg histogram on a real time axis and rework the page
    The Snáška chart had a category axis: no tick marks, one label per bar,
    and the window ended at the start of the last bar, so 24 hours read
    18:00 to 17:00. It now uses a linear time axis like the voltage chart,
    with tick marks and labels on both ends. The window is whole hours,
    days or weeks (24 hours run from 18:00 to 18:00), and every bar is the
    eggs laid in its interval: a check at 10:00 reports what was laid since
    9:00, so it counts towards 9:00-10:00, and the hour that is still
    running stays empty until the next check reports it. "Today" on the
    nest tiles is counted the same way. Vše starts at the first reading, as
    the vol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
2026-10-02 Pick nests in a dialog and refuse duplicate commands
    The nest picker is now a button that opens a dialog; the selection only
    takes effect after Potvrdit, and Vynulovat/Kalibrovat stay disabled until
    some nest is chosen. A command whose downlink is already waiting in the
    queue is refused with 409 and a neutral toast instead of being queued
    again. On phones the nest card turns into a compact list with one row per
    nest so 15 nests fit on about one screen.
    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
2026-10-02 Cover every nest state in the test databases
    Two new databases: kurnik-test-instalace.db (first day after installation,
    nest 1 tared and calibrated through off-the-hour messages, nest 2 still
    uncalibrated) and kurnik-test-15.db (15 nests, the last check shows every
    state at once; needs NEST_COUNT=15). The broody hen moves from the red
    porucha database to the orange poplach one, where nest 1 answers and the
    chain breaks behind it. Full baskets now fill up egg by egg in the morning
    instead of jumping to ten, so the egg histogram has no fake bars, and the
    nest count is set per database.
    Claude-Session: https://claude.ai/code/session_01Jfg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
2026-10-02 Cap the nest status polling at a hard 10 s
    The last status query used to start just before the 9 s limit and could
    run 0.2 s past it. A query is now sent only if its reply window still
    fits in the limit, and the limit is 10 s, so polling never takes longer
    than 10 s and one nest never longer than 15 s, which is what the radio
    idle check already reserves per nest. The slave now has up to 13.5 s
    after the command, still well above the 10.1 s of a drift check.
    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
    [nests.c]
2026-10-03 Recount the egg check and radio budget in the README
    Kontrola vajec: the time per nest now includes the bus exchanges and,
    for the maximum, one extra status query plus the daily drift check, which
    the t_max formula referenced without defining. The P-MOS switch times get
    a minimum and a maximum, and every symbol used is listed under kde.
    Komunikace: the uplink airtime is computed from the LoRa formula with the
    13 B LoRaWAN overhead and CRC, giving 185 ms for 5 B and 165 ms for 2 B
    instead of 150 and 130 ms, so transmitting takes about 25 s a day. The
    maximum current row is 25.8 mA like the typical one.
    The share table uses the current door maximum of 10.1 mAh; the day now
    totals 2.10 mAh ty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
2026-10-03 Detect a door obstacle after 150 ms and fix the egg check numbers
    The motor now reports an obstacle once the current stays above the limit
    for 150 ms instead of 250 ms; the README says so too.
    In the egg check the maximum column follows the rounded t_max of 8.8 min,
    the pull-up switches add up to 26.2 min (1572 s) rather than 26.5, t_r is
    described per load cell, and the LoRa symbol count gets its ceiling back,
    without which the 5 B frame would come out at 29 symbols instead of 33.
    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
    [motor.c]
2026-10-03 Hide the running hour in Snáška, explain its dashes, purple panel line
    The egg histogram and its table now end with the last interval a check
    could already have reported: an hour is shown once the following
    hourly check is due, so at 15:30 the 24 h view runs from 15:00 to 15:00
    instead of ending in an always empty 15:00–16:00 column. Day and week
    columns still include today and this week, which fill up as checks come
    in. The 24 h window keeps its full 24 columns.
    GUIDE.md now explains, like it does for the voltages, what a dash and
    a zero mean in Snáška, when a whole row or a single nest goes blank, and
    that eggs laid during an outage show up with the first check after it.
    The panel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
2026-10-03 Name the nest list in the TTN formatter in English like the other keys
    The formatter's keys are English (panel_mv, battery_mv, door) and its
    values readable Czech words; the nest list broke that with the key
    hnizda and the helper hnizdo. They are now nests and nest(code); the
    values stay Czech like the door states. Only the TTN console shows this
    output, the server decodes the raw payload itself.
    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
2026-10-03 Put the panel line back to its original orange
    The panel series returns to the palette orange it had before the nest
    work, #eb6834 on light and #d95926 on dark; both pass the palette checks
    against the blue battery line in their theme.
    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
2026-10-07 Turn on the LPUART FIFO for the nest link
    An RTC alarm interrupt can outlast one character at 1 MHz, so the
    master could lose a byte of a nest reply. The 8-byte FIFO rides that out.
    Claude-Session: https://claude.ai/code/session_01VXqzpUdJdwrRMQeFngYbbv
2026-10-07 Treat the radio as busy while LoRaWAN is on air
    The modem returns a 120 s failsafe sleep while lr1mac sends or waits
    for its receive windows, which read as idle. Ask lr1mac for its state.
    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
    [lora_app.c]
2026-10-07 Move the door resync out of the hourly nest check
    At hh:00:05 its alarm landed inside the nest session; hh:05:00 is clear
    of it and of the battery checks at hh:x0.
    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
2026-10-07 Keep the door resync off the minute
    Sun events fall on whole minutes, so at hh:05:00 one could tie with the
    resync, which wins and skips the move while an obstacle retry waits.
    hh:05:30 never ties and leaves more room after the nest session.
    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
    [door.c]
2026-10-07 Catch up the door when a retry points the wrong way
    With the resync on the full hour, a long nest check can push the
    door's resync past a sun event at hh:01, and the event moves to the next
    day. The catch-up then has to close or open the door, but it gave way to
    any pending obstacle retry, so a stale retry in the old direction ran
    and ended in a fault. A retry now only holds the catch-up back while it
    points where the door should go.
    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
    [door.c]
2026-10-07 Wait up to 3 x 10 s for the radio
    On TTN the first receive window opens 5 s after the uplink, so one
    uplink keeps the radio busy for about 7-12 s, and the time request and
    the hourly results can go out back to back. 20 s could cut into the
    second one; 30 s covers both.
    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
2026-10-07 Start the radio wait afresh once deferred work is dropped
    A door fault, a disabled door, a filtered-out event or nests with
    nothing to do left the defer count where it was, so the next wait for
    the radio could end after one check instead of three.
    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
2026-10-07 Keep the nest plan through a small time correction
    The planned check always sits on a full hour, so a correction of less
    than an hour does not move it. Re-planning only after the clock went
    back by more than an hour stops a nest check that has just run from
    running again when the time answer comes in right after it.
    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
    [nests.c]
2026-10-07 Let a running nest deferral finish through a time correction
    Nests_Reschedule re-armed the shared timer to the next full hour, so a
    tare or calibration waiting for the radio slipped up to an hour and the
    next check inherited the defer count. While a deferral runs, its 10 s
    timer now stays and the next pass looks at the corrected clock.
    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
    [nests.c]
2026-10-07 Keep an obstacle retry behind a deferred door move
    While a request or a sun move waited for the radio, a due retry could
    still take the timer and run first. On a third obstacle that faulted
    the door and dropped the user's command; against a deferred sun move it
    made a stroke the wrong way, and it cut the radio wait short. The
    deferred move now runs first; it either clears the retry or is the
    retry itself.
    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
    [door.c]
2026-10-07 Drop a retry that fired during a door move
    If the retry timer went off while a manual move was running and that
    move hit an obstacle, the latched retry ran on the next pass, a few
    seconds later instead of after 5 min, and the door could fault early.
    A latched retry or defer is now dropped after a move; Door_Schedule
    arms them again from the current state.
    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
2026-10-08 Skip a battery mark that is less than half a period away
    A time sync re-anchors the second boundaries, so the timer armed for
    hh:10 could fire at hh:09:59. The check ran, picked hh:10:00 again and
    ran a second time a second later, with a second status uplink.
    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
    [battery.c]
2026-10-08 Request the time every 12 h, not 13 h
    The sync is stamped when the answer arrives, a few seconds after the
    full hour, while the 12 h check runs on the hour, so it always came up
    a few seconds short and slipped by an hour. Half an hour of slack
    keeps it on 12 h.
    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
    [door.c]
2026-10-08 Let a pending resync stand when a catch-up is queued
    The catch-up after a move wrote SUN over a resync that had fired during
    the move, so that hour's time-sync check was skipped. The resync does
    its own catch-up, so it is kept and runs instead.
    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
    [door.c]
2026-10-08 Leave the door alone when a sun event is about to put it there
    A catch-up within the last minutes before an event, after switching the
    system on, unblocking, a battery recovery or a time correction, moved
    the door back to the pre-event end and the event then moved it again.
    If the door already sits where an event within 5 min will put it, the
    catch-up and the sun move now take that direction.
    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
    [door.c]
2026-10-08 Catch up the door after joining the network
    The JOINED handler only rescheduled the door. If it ran in the second of
    a sun event, before the door timer fired, the event moved to the next
    day, and with the time answer lost the door moved only at the next
    hourly resync, up to an hour late.
    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
2026-10-08 Tidy the server backend and close command and downlink edge cases
    Reject command names inherited from Object.prototype, keep stale or foreign
    downlink events from clearing an unrelated pending command, delete readings
    and nests in one transaction, make the SQLite layer synchronous to match
    node:sqlite, and drop duplicated constants and per-call statement prepares.
    Claude-Session: https://claude.ai/code/session_011kyzyVB1jR55xsyjqECoyf
2026-10-08 Rework the dashboard frontend for correctness and one consistent style
    Drop stale range responses, reload charts whenever the status snapshot
    changes (reconnects, wipes, missed uplinks), take label precision from the
    bucket size the server now returns, keep data on a failed refresh, show
    HTTP results without relying on the WebSocket echo, guard busy buttons and
    the wipe dialog, fix the theme toggle under a dark OS scheme and apply the
    stored theme before first paint on both pages, share request handling in
    common.js, and normalise HTML, CSS and naming.
    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
2026-10-08 Fix review findings in the dashboard rewrite
    Always draw a reading that has no neighbour so single or sparse readings
    stay visible, keep minute-precision ticks distinct on short spans, do not
    claim an empty database when the first load fails, use an AbortController
    timeout for iOS 15, keep the primary button border on hover, and update
    GUIDE.md for the new toast text, decimal comma and averaging hint.
    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
2026-10-08 Show dashboard times in the coop's time zone
    The server already buckets days and weeks in its own TZ, so it now sends
    that zone in the status and the page formats every time, the today check
    and the noon and whole-hour axis ticks in it, whatever the browser's zone.
    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
2026-10-09 Tighten motor control and sun times
    Debounce the target endstop before ending a stroke, scale the duty to the
    full PWM period, count the first over-limit sample in the 150 ms obstacle
    window, release TIM17 and the EN pin after each move, compute sunrise and
    sunset with the NOAA solar position (max error 0.7 min instead of 3.9 min)
    without wrapping each time on its own, and let the 2026-01-01 local
    fallback time survive a reset.
    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
    [astro.c, motor.c, motor.h, timebase.h]
2026-10-09 Fix door state machine edge cases and unify the door, motor and time code
    Hold obstacle retries while automation is held, re-check a manual
    override before its retry runs, let the override expire during a battery
    hold, take the override from the command's real age instead of the
    fallback clock and keep it until the first sync, retry automatic moves
    toward the current sun direction, re-read the endstops when automation
    is switched back on, open all day when daylight plus offsets cover the
    whole day, and power the motor peripherals down at boot. Fold repeated
    work resets and request handlers into helpers, prefix the stroke enum,
    make Endstop_Release private and drop dead cache invalidations.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
    [battery.c, door.c, endstop.c, endstop.h, motor.c, timebase.c, timebase.h]
2026-10-09 Keep the automation switch across an MCU reset
    Store the on/off state next to the door fault in the backup register and
    switch the nest checks off at boot when the system was off before.
    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
    [door.c, main.c]
2026-10-09 Use confirmed downlinks and default the automation tile to on
    Send commands as confirmed downlinks, keep sent commands until their ack
    or nack so both events carry the command, put a nacked command back in
    the queue as TTN re-sends it, update the automation tile only on an ack,
    show the device default when no command was confirmed yet, and stretch
    the lone fifth tile across the phone layout.
    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
2026-10-09 Lighten the warning colour and add a switched-off automation to the test data
    The poplach and porucha databases now carry an automation state switched
    off a day and two hours earlier, so both formats of the since time show.
    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
2026-10-10 Correct the server memory and power cost figures in the guide
    Measured the server at about 100 MB after start and up to 155 MB after
    loading every chart range, and 1 W for a year comes to roughly 50 Kč.
    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
2026-10-10 Drop the switched-off automation from the porucha test database
    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
2026-10-12 Retry INA226 access three times and even out the power chart axes
    Every INA226 register transfer and the bus power-up now take up to three
    attempts, and an implausible battery voltage outside 1-10 V is measured
    again up to three times both in the battery check and around the motor
    stroke. The power chart puts its time labels on aligned, evenly spaced
    steps of the coop's clock and never splits the voltage axis finer than
    10 mV.
    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
2026-10-12 Keep INA226 retries flat and power chart ticks safe across DST
    Register reads are single-shot so the battery and motor loops own the
    three attempts, power-up fails when the bus stays stuck after recovery,
    the battery block allows the worst-case retry time, and tick alignment
    steps over nonexistent or repeated local hours.
    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
2026-10-12 Put chart axis labels on round calendar values
    Both the power and the egg chart now share one tick generator that
    picks minute, hour, day, week, month or year steps, aligns them in the
    server time zone and drops the 12:00 time and the forced last label.
    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
2026-10-12 Cap Vše at five years and average long ranges by month
    Vše now starts on the first day of the month 60 months back, eggs switch
    to monthly bars beyond a year and power to monthly averages beyond two
    years, and a note under both charts explains the limit.
    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
2026-10-12 Keep the Vše outage visible in the test DB and fix the outage guide
    The full test history is 720 days so Vše still averages power by week
    and shows the 21-day outage; the guide now says the Vše threshold
    follows the history length.
    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
2026-10-12 Cap Vše tables at five years again and add a five-year test DB
    Vše tables follow the charts again and show the last five years. The
    new kurnik-test-dlouhy.db covers monthly power and egg averages, the
    five-year cutoff, a two-month gap and a month without the panel.
    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
2026-10-12 Never run a late tare or calibration and accept cold panel voltages
    A tare or calibration that cannot run right away (critical battery, a
    nest that does not answer) is dropped instead of firing at a later
    hourly check, when eggs may be in the nest or the weight gone. Panel
    readings count as valid up to ADC saturation, so a cold-morning open
    circuit voltage above 12.5 V is reported as saturated, not as a dead
    sensor. INA226 reads the current register only when asked for it and
    the PLL wait uses the same tick conversion as the rest of the code.
    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
2026-10-13 Run LP Run at 2 MHz so the INA226 I2C bus stays within spec
    The STM32WLE5 needs an I2C kernel clock of at least 2 MHz in Standard
    mode (datasheet table 90), but LP Run gave it 1 MHz. LP Run now uses
    MSI at 2 MHz, the I2C timing is derived from the Standard-mode limits
    for SCL low/high, data setup and SDA hold (the old values broke the
    setup and hold limits even at 48 MHz), and the bus refuses to start
    below 2 MHz. README power figures follow the higher LP Run current
    and the faster panel ADC clock.
    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
2026-10-13 Keep the on/off switch and door fault across power loss and measure the battery first at boot
    The door state word now also lives in a checked flash record on the free NVM page,
    so a full power loss no longer re-enables the system or clears a door fault. The
    battery is measured once at boot before the first nest check, the hourly full uplink
    is sent only after the fresh battery measurement, and a forward time sync more than
    an hour past the planned nest check no longer triggers an extra check.
    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
2026-10-13 Carry a dropped full uplink into the next one and tidy the boot and RNG code
    A full uplink that could not be sent, because the coop had not joined yet or the
    modem refused it three times, is now added to the next uplink, so the nest card
    updates right after joining instead of up to an hour later. The boot no longer
    configures the INA226 twice, since the first battery measurement does it, and
    GetRandomValue keeps its behaviour in the house style and always switches the
    RNG off. The guide and README now say that the modem acknowledges a command
    within seconds.
    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
2026-10-13 Number every command so a repeated downlink never runs twice
    When the coop's acknowledgement is lost, TTN sends the same confirmed downlink
    again, so a calibration could run a second time after the weight was removed, or
    the door could open again hours later. The server now adds a number from 1 to 255
    to every command, in a second byte flagged by bit 6 of the first, and keeps the
    last number in the settings table. The coop remembers the last four numbers and
    ignores a downlink it has already carried out. The random number generator now
    tries ten times before it falls back.
    Claude-Session: https://claude.ai/code/session_011kyzyVB1jR55xs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
2026-10-13 Expire commands that do not reach the coop within 30 minutes
    A command could sit in the TTN queue while the gateway was down and run hours
    later, for example opening the door at night. The server now drops commands
    older than 30 minutes from the network queue, also when TTN puts back an old
    command after a missing acknowledgement, and tells the page "Příkaz vypršel".
    It also empties the network queue when it starts, because it no longer knows
    how old the commands left there are. The README no longer explains the command
    number and drops the English term in brackets.
    Claude-Session: https://claude.ai/code/session_011kyzyVB1jR55xsyjqE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
2026-10-13 Show a failed logout in the header next to the logout button
    The error used to appear in the command card at the bottom of the page, out of
    sight on a phone, and it replaced any command message there. It is now a red
    "Odhlášení selhalo" badge beside the header buttons, with the reason on hover,
    and it disappears on the next attempt.
    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
2026-10-13 Keep the header alerts in one right-aligned row on phones
    The database and logout alerts sat in different rows with different alignment,
    so they looked shifted. Both now share one group between the connection
    indicator and the buttons: on a phone it is its own right-aligned row, on wider
    screens it stays inline. Rows that wrap on mid-size screens are right-aligned
    too, so the buttons no longer jump to the left edge.
    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
2026-10-13 Remember executed commands across coop resets and stop retries after a rejoin
    The coop kept the numbers of executed commands in RAM, so a retry arriving
    right after a reset could run a command twice. It now keeps the last four
    commands, each as number and queue time, in RTC backup registers 8 to 11,
    which survive every MCU reset. A full power loss clears those registers, and
    every restart makes the coop join again, so the server now listens to join
    events. On a join it purges the TTN queue down to the commands that were never
    sent, stops retrying commands that were sent but not confirmed, and the page
    says "Kurník se restartoval dřív, než příkaz potvrdil".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
2026-10-13 Add the nest unit firmware: Modbus slave, HX711 egg counting, EEPROM state and hand-over
    The nest controller answers the master's Modbus RTU commands (measure,
    tare, calibrate, release) over RS485 with DMA reception to idle, filters
    32 HX711 samples around the median, counts eggs, detects a broody hen,
    re-zeroes drift once a day and keeps calibration and count in two
    checked EEPROM records. It boots at 2 MHz to meet the 10 ms budget,
    runs in LP Run at 131 kHz after the first command, leaves it for EEPROM
    writes and on release powers the next box and enters Stop.
    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
2026-10-13 Clock the master LPUART from MSI locked to LSE during nest communication
    With LSE as its kernel clock the master LPUART divides only 874 BRR steps
    per bit, so its receiver tolerates the least deviation of the nest
    replies, whose MSI drifts with temperature. During nest communication the
    master now enables MSI PLL mode, measures MSI against LSE with TIM16 and,
    when it is within 0.5 %, moves the LPUART to PCLK1 (2 MHz, BRR about
    53 000). Otherwise the LPUART stays on LSE as before.
    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
2026-10-16 Allow one queued command per pair and per nest, plain tooltip swatches
    The queue now refuses a command when the same or the opposite command of
    its pair is still waiting (open/close, unblock/block, on/off), and a
    tare or calibration for a nest that already has one queued. A command
    older than the 30-minute limit no longer blocks its pair. The page names
    the waiting command in the refusal. The power chart tooltip draws plain
    series-coloured swatches instead of white-framed ones in light mode.
    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
2026-10-16 Replace a queued nest command with the same one for more nests
    A tare or calibration for nests that overlap a queued command of the same
    kind no longer gets refused when it adds a nest: the queued command is
    replaced by one for all the nests together, e.g. tare nest 1 followed by
    tare all nests leaves a single tare for all. A request that adds no nest
    is still refused, and tare and calibration still never replace each
    other. The page names the replaced command.
    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
2026-10-16 Keep unusual chart and table events only in kurnik-test.db
    The other test databases no longer carry outages, readings without
    values, saturation, a flat battery, a disconnected panel, broody or
    silent nests in their history; only the end state they exist for stays,
    starting just before generation. The long database loses its 100-day
    outage and 62-day panel event. Databases regenerated in Prague time.
    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
2026-10-19 Added comms schematic
2026-10-21 Nevynulovaná váha: kalibrace bez vynulování se odmítne místo poruchy
    - Hnízdo, které nebylo nikdy vynulované, hlásí nový příznak (bit 3)
    a v uplinku kód 13; kalibraci bez vynulování zahodí bez poruchy váhy
    - Server kalibraci takového hnízda neodešle a stránka napíše,
    že je potřeba nejdřív vynulovat
    - Karta Hnízda: „váha není zkalibrovaná, nejdřív ji vynulujte“
    - README, GUIDE, testovací databáze instalace
    Claude-Session: https://claude.ai/code/session_01Q9mMzfa7jZD868MCiUTb7R
2026-10-21 README: krokový motor, zavírání po západu a odstavec o serveru
    Druhá polovina odstavce o rádiu (brána, TTN, server) přesunuta do
    samostatného odstavce doplněného o Docker, Tailscale a webový manifest.
    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
2026-10-21 README: úsporný Mx, třída A, daisy chain, 6V systém, H-bridge
    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
2026-10-21 README: různé formulace u úsporných obvodů, kratší věta o 6 V
    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
2026-10-21 README: proč daisy chain a ne hvězda
    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
2026-10-21 README: krokový motor nad vztah pro tah, limity TTN a 7 zpráv v jednom odstavci, parametry LoRaWAN
    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
2026-10-21 README: bez MAX3483, Node.js zpět u Raspberry Pi
    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
2026-10-23 Count eggs incrementally and redraw flowcharts
    Nest firmware (Slave/Core/Src/nest.c):
    - Egg count is now kept per nest and changed by increments: a gain of at
    least 30 g is rounded to whole 60 g eggs and added, a loss is converted
    using the average weight of the eggs in the nest. Differences in egg
    size no longer accumulate (10 eggs of 55 g were reported as 9).
    - Slow changes of 10-29 g (litter, droppings) only move the reference
    weight, so they no longer add up to a phantom egg.
    - An empty nest (within +-25 g) always resets the count to zero.
    - EEPROM count record v2 (NES2) stores the count and egg weight; v1
    records are migrated on load.
    README: egg detection list matches the fi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
2026-10-23 Tidy egg detection list, drop flowchart generator
    - README: remove the rounding example and move the full basket item
    after the empty nest item.
    - Remove Flowcharts/flowcharts.py.
    Claude-Session: https://claude.ai/code/session_01DYCoxUTLA5PupqUXf9ViGw
2026-10-23 Egg flowchart: check empty nest before full basket
    Same order as the egg detection list in README.
    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
2026-10-23 Flowcharts: no merging arrows right above the next arrow
    Side branches now enter a block directly instead of joining the main
    line just above the next arrowhead:
    - Separator: the panel wait step enters "Navzorkuj napětí panelu" from
    the side; "Zapni kritický režim" leads straight to the panel voltage
    check (a discharged battery cannot be fully charged).
    - Egg detection: same order as the firmware - empty nest, then egg
    change, then full basket; "no change" goes straight to sending.
    - Door: "Běží motor příliš dlouho?" enters the fault block from the side.
    README: egg detection list in the same order as the diagram.
    Clau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
2026-10-24 Keep manual commands working while the automation is off
    Turning the automation off now stops only the sun-driven door moves and
    the hourly nest check. Open, Close, Tare and Calibrate are carried out
    as before; a blocked door and a critically low battery still refuse
    them. Turning the automation back on drops any manual override, so the
    door goes straight to where the sun wants it unless the same downlink
    also carries Open or Close.
    GUIDE.md describes the new behaviour.
    Claude-Session: https://claude.ai/code/session_013KgJxUgWfpH4frb62NstZD
2026-10-24 Modified resistor values
2026-10-24 Move battery checks onto the real 10-minute grid after the first time sync
    After a power loss the master boots on the fallback clock, so the first
    periodic battery check landed about 10 minutes after power-up instead of
    on a x:x0 mark. The first network time sync now reschedules the battery
    check as well, like the door and the nests. Later 12-hourly syncs leave
    it alone, so they can never skip a check.
    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
2026-11-10 PCB schematic
2026-11-10 Updated block schematic
2026-11-14 Finished PCB schematics
