Hosty-04/ChickenCoop/(notices)

Notices in the files:
Master/LoRaWAN/App/lora_app.c:
Copyright (c) 2026 STMicroelectronics.
All rights reserved.
This software is licensed under terms that can be found in the LICENSE file
